fiskebolle30/Bachelor_Electronics_hardware/README.md

# Bachelor_Electronics_hardware
All PCB design files for the bachelor project. Project is made in KiCad
