fiskebolle30/Bachelor_Electronics_hardware/Bachelor_Main_PCB/Bachelor_Main_PCB_simple.step

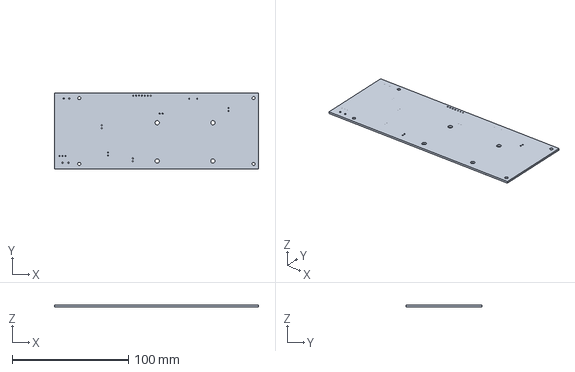
[picture p1: CAD file, 2025-04-30]
Bachelor_Main_PCB/Bachelor_Main_PCB_simple.step
175.8 x 65.1 x 1.52 mm
