fiskebolle30/Bachelor_Electronics_hardware/Bachelor_Main_PCB/KiCAD-Library_Bachelor_PCB/0402ESDA-MLP1/0402ESDA-MLP1.step

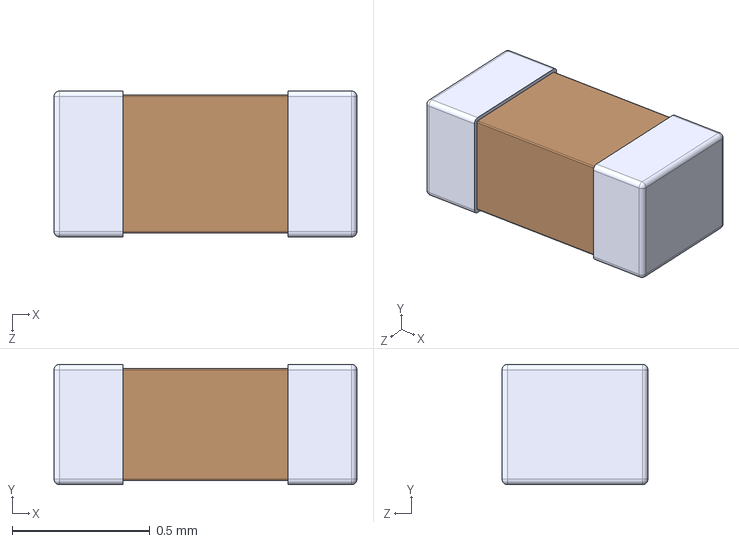
[picture p2: CAD file, 2025-04-09]
Bachelor_Main_PCB/KiCAD-Library_Bachelor_PCB/0402ESDA-MLP1/0402ESDA-MLP1.step
1.10 x 0.436 x 0.53 mm
