fiskebolle30/Bachelor_Electronics_hardware/Bachelor_Main_PCB/KiCAD-Library_Bachelor_PCB/BK-916-TR/BK-916-TR.step

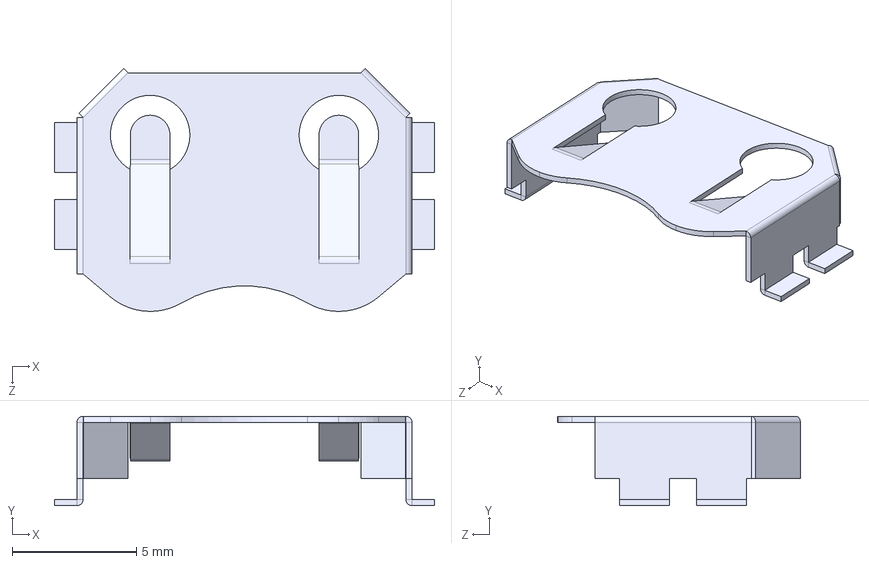
[picture p3: CAD file, 2025-04-02]
Bachelor_Main_PCB/KiCAD-Library_Bachelor_PCB/BK-916-TR/BK-916-TR.step
15.3 x 3.60 x 9.78 mm
