fiskebolle30/Bachelor_Electronics_hardware/Bachelor_Main_PCB/KiCAD-Library_Bachelor_PCB/CONMHF1-SMD-G-T/CONMHF1-SMD-G-T.step

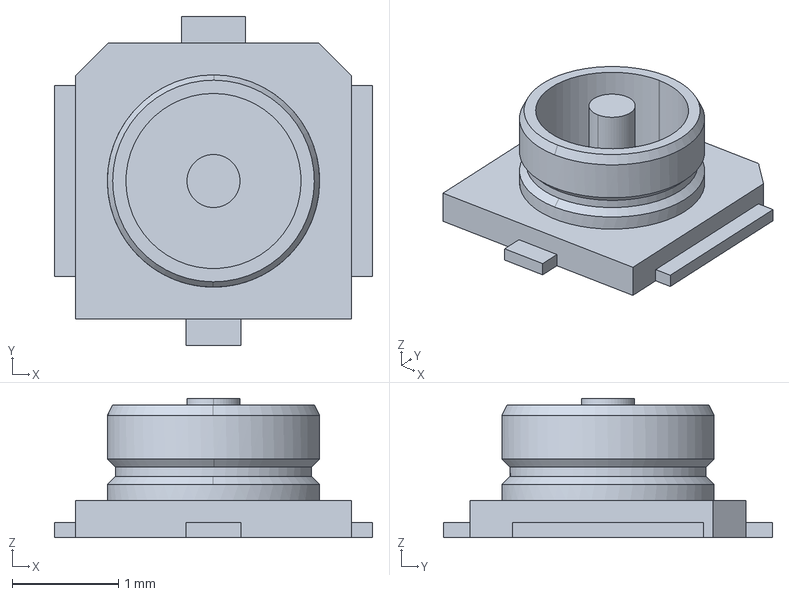
[picture p4: CAD file, 2025-04-09]
Bachelor_Main_PCB/KiCAD-Library_Bachelor_PCB/CONMHF1-SMD-G-T/CONMHF1-SMD-G-T.step
3.00 x 3.10 x 1.31 mm
