fiskebolle30/Bachelor_Electronics_hardware/Bachelor_Main_PCB/KiCAD-Library_Bachelor_PCB/ECS-327TXO-30-TR/ECS-327TXO-30-TR.step

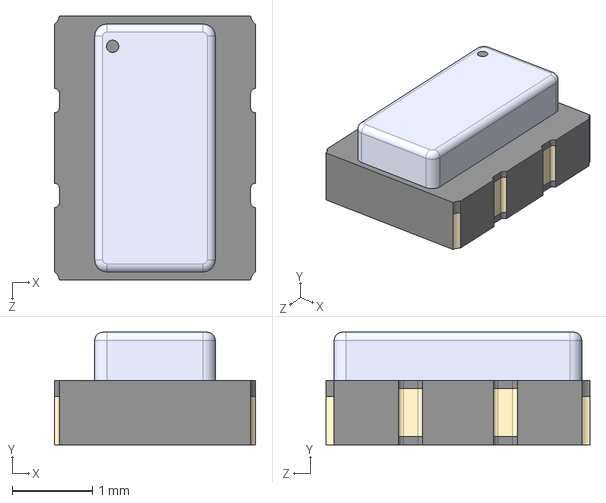
[picture p5: CAD file, 2025-04-04]
Bachelor_Main_PCB/KiCAD-Library_Bachelor_PCB/ECS-327TXO-30-TR/ECS-327TXO-30-TR.step
2.50 x 1.40 x 3.28 mm
