fiskebolle30/Bachelor_Electronics_hardware/Bachelor_Main_PCB/KiCAD-Library_Bachelor_PCB/F32Q-1A7H1-11022/F32Q-1A7H1-11022.step

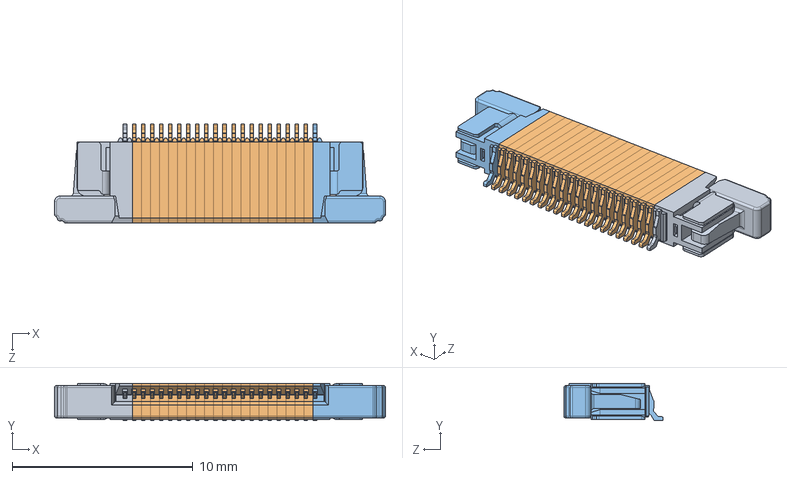
[picture p6: CAD file, 2025-03-14]
Bachelor_Main_PCB/KiCAD-Library_Bachelor_PCB/F32Q-1A7H1-11022/F32Q-1A7H1-11022.step
18.3 x 2.05 x 5.50 mm
F32Q_L.STEP
F32Q_M.STEP x 20
F32Q_R.STEP
