fiskebolle30/Bachelor_Electronics_hardware/Bachelor_Main_PCB/KiCAD-Library_Bachelor_PCB/LIB_BC817-40Q-13-F/BC817-40Q-13-F/3D/BC817-40Q-13-F.stp

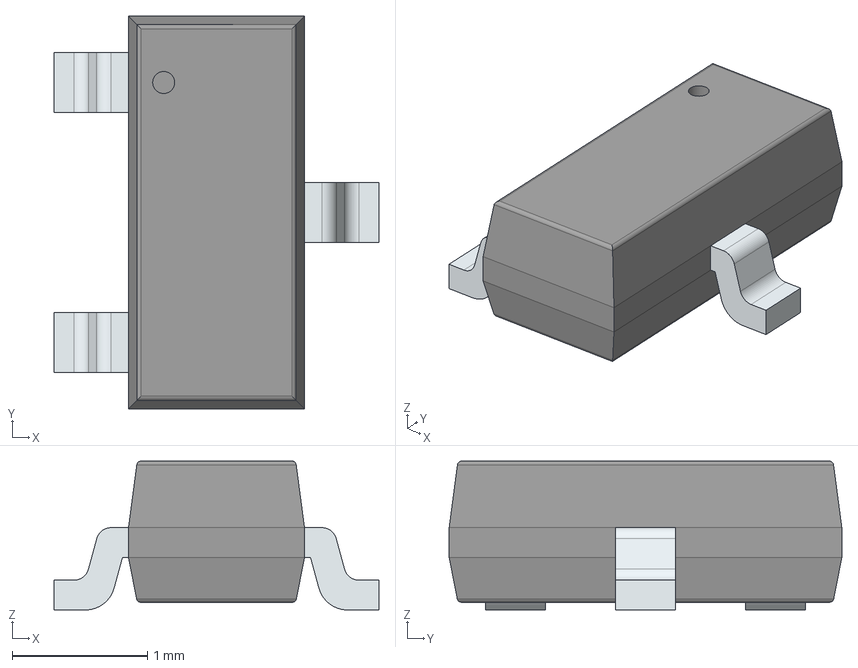
[picture p7: CAD file, 2025-04-15]
Bachelor_Main_PCB/KiCAD-Library_Bachelor_PCB/LIB_BC817-40Q-13-F/BC817-40Q-13-F/3D/BC817-40Q-13-F.stp
2.40 x 2.90 x 1.10 mm
PinsArrayL
FilletPinR
