fiskebolle30/Bachelor_Electronics_hardware/Bachelor_Main_PCB/KiCAD-Library_Bachelor_PCB/LIB_ESD7004MUTAG/ESD7004MUTAG/3D/ESD7004MUTAG.stp

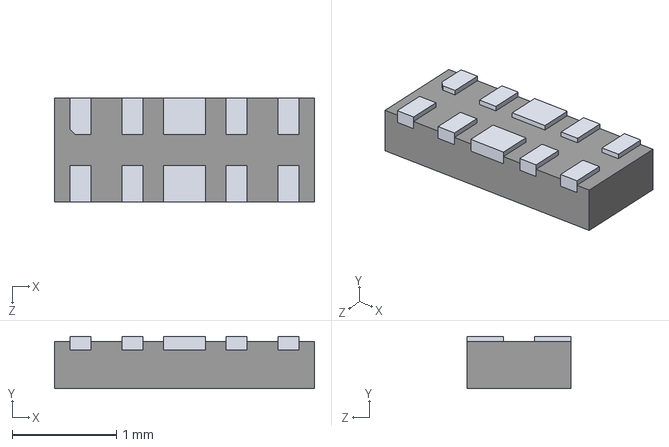
[picture p8: CAD file, 2025-04-07]
Bachelor_Main_PCB/KiCAD-Library_Bachelor_PCB/LIB_ESD7004MUTAG/ESD7004MUTAG/3D/ESD7004MUTAG.stp
2.50 x 0.5 x 1.00 mm
