fiskebolle30/Bachelor_Electronics_hardware/Bachelor_Main_PCB/KiCAD-Library_Bachelor_PCB/LIB_LD3985M18R/LD3985M18R/3D/LD3985M18R.stp

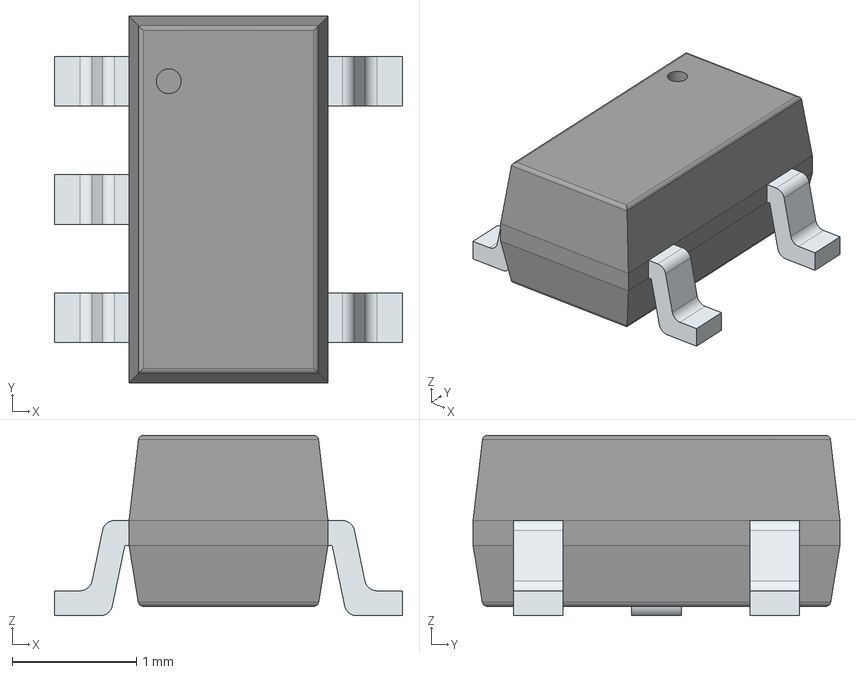
[picture p9: CAD file, 2025-04-12]
Bachelor_Main_PCB/KiCAD-Library_Bachelor_PCB/LIB_LD3985M18R/LD3985M18R/3D/LD3985M18R.stp
2.80 x 2.95 x 1.45 mm
PinsArrayL
PinsArrayR
