fiskebolle30/Bachelor_Electronics_hardware/Bachelor_Main_PCB/KiCAD-Library_Bachelor_PCB/LIB_SSM3J358R,LF/SSM3J358R,LF/3D/SSM3J358R,LF.stp

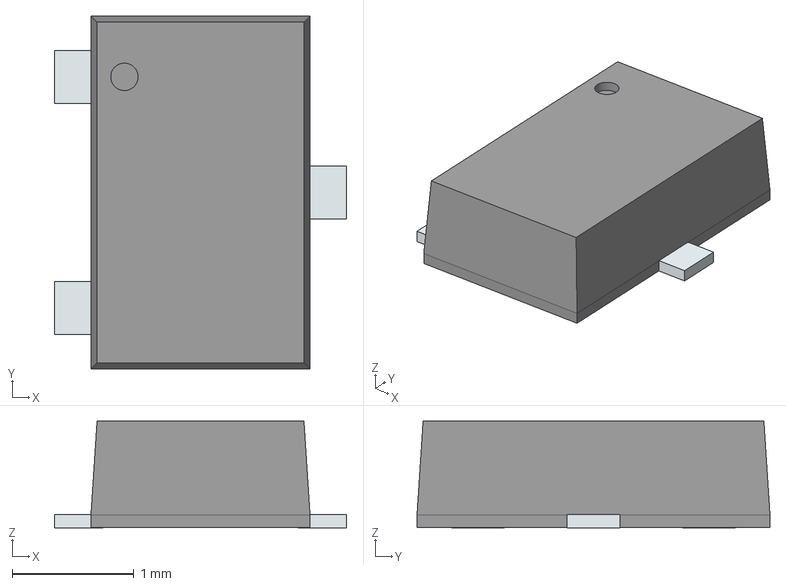
[picture p10: CAD file, 2025-04-08]
Bachelor_Main_PCB/KiCAD-Library_Bachelor_PCB/LIB_SSM3J358R,LF/SSM3J358R,LF/3D/SSM3J358R,LF.stp
2.40 x 2.90 x 0.878 mm
PinsArrayL
PinsArrayR
