fiskebolle30/Bachelor_Electronics_hardware/Bachelor_Main_PCB/KiCAD-Library_Bachelor_PCB/LQM2HPN1R0MJHL/LQM2HPN1R0MJHL.step

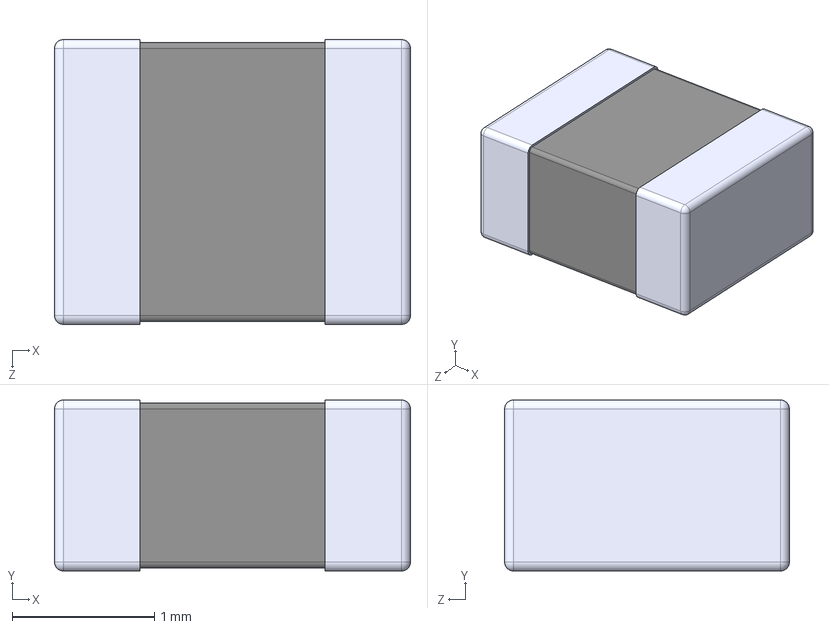
[picture p11: CAD file, 2025-04-01]
Bachelor_Main_PCB/KiCAD-Library_Bachelor_PCB/LQM2HPN1R0MJHL/LQM2HPN1R0MJHL.step
2.50 x 1.20 x 2.00 mm
