fiskebolle30/Bachelor_Electronics_hardware/Bachelor_Main_PCB/KiCAD-Library_Bachelor_PCB/LTST-C190GKT/LTST-C190GKT.step

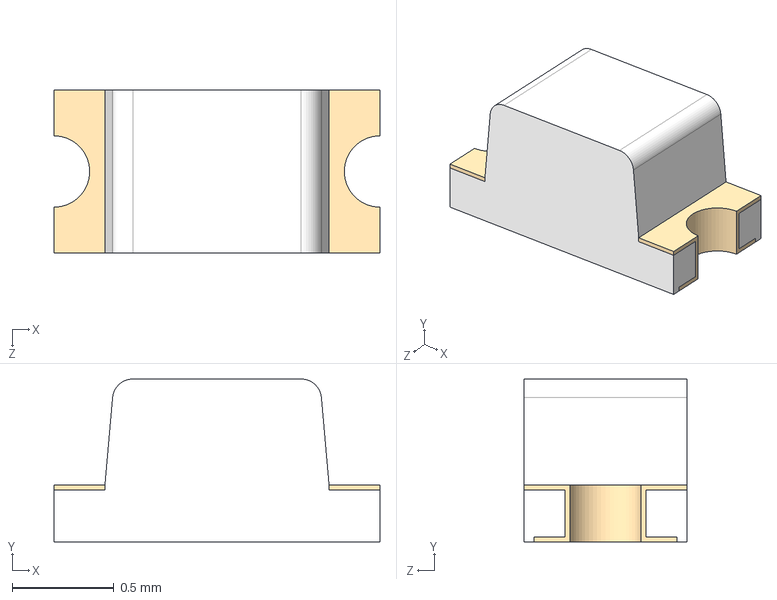
[picture p12: CAD file, 2025-04-15]
Bachelor_Main_PCB/KiCAD-Library_Bachelor_PCB/LTST-C190GKT/LTST-C190GKT.step
1.60 x 0.8 x 0.8 mm
