fiskebolle30/Bachelor_Electronics_hardware/Bachelor_Main_PCB/KiCAD-Library_Bachelor_PCB/MEM2075-00-140-01-A/MEM2075-00-140-01-A.step

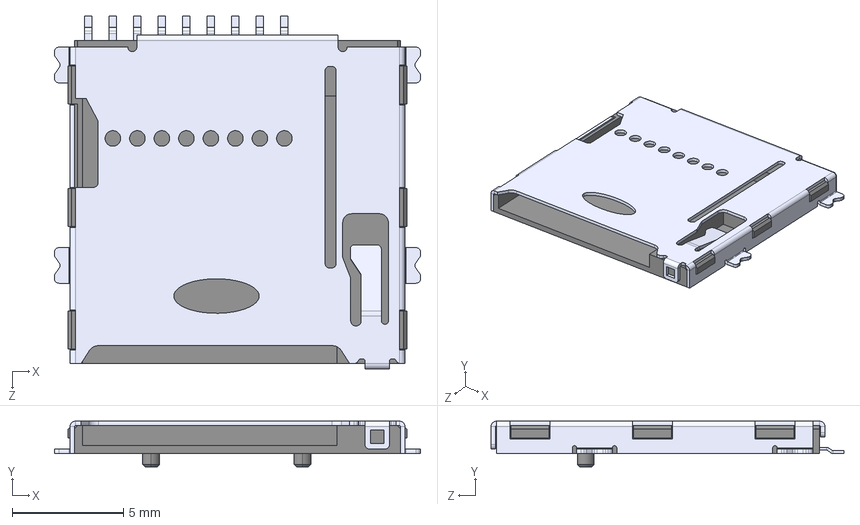
[picture p13: CAD file, 2025-04-09]
Bachelor_Main_PCB/KiCAD-Library_Bachelor_PCB/MEM2075-00-140-01-A/MEM2075-00-140-01-A.step
16.4 x 2.05 x 15.9 mm
