fiskebolle30/Bachelor_Electronics_hardware/Bachelor_Main_PCB/KiCAD-Library_Bachelor_PCB/SF70S006VBAR2000/SF70S006VBAR2000.step

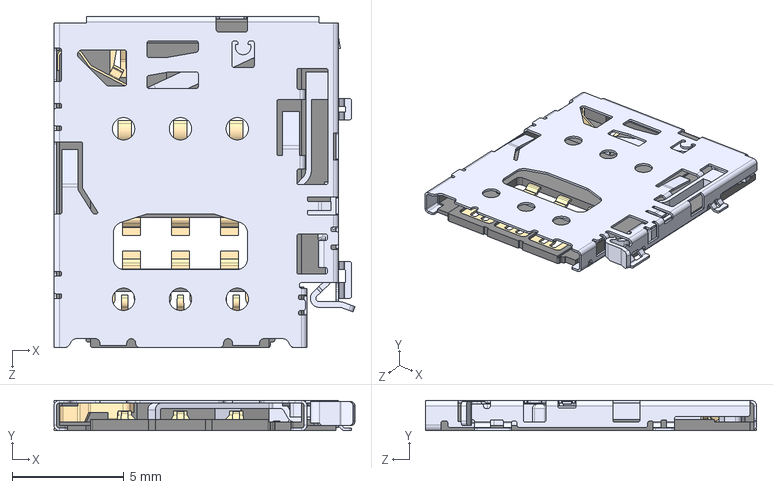
[picture p14: CAD file, 2025-04-22]
Bachelor_Main_PCB/KiCAD-Library_Bachelor_PCB/SF70S006VBAR2000/SF70S006VBAR2000.step
13.5 x 1.35 x 14.8 mm
