fiskebolle30/Bachelor_Electronics_hardware/Bachelor_Main_PCB/KiCAD-Library_Bachelor_PCB/SG-210STF_1.2000ML/SG-210STF_1.2000ML.step

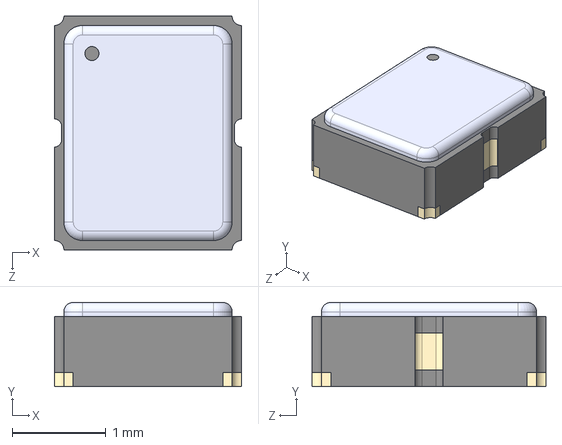
[picture p15: CAD file, 2025-03-26]
Bachelor_Main_PCB/KiCAD-Library_Bachelor_PCB/SG-210STF_1.2000ML/SG-210STF_1.2000ML.step
2.00 x 0.9 x 2.50 mm
