fiskebolle30/Bachelor_Electronics_hardware/Bachelor_Main_PCB/KiCAD-Library_Bachelor_PCB/USB3320C-EZK-TR/USB3320C-EZK-TR.step

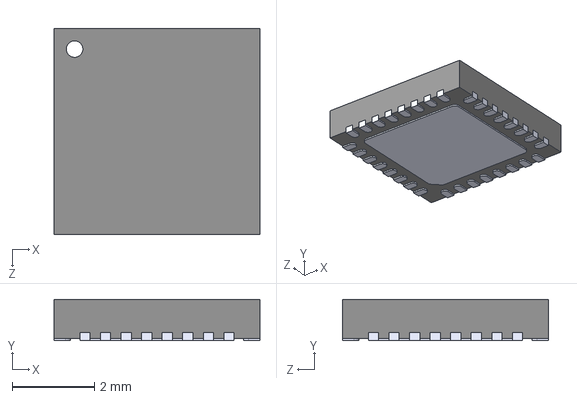
[picture p16: CAD file, 2025-03-24]
Bachelor_Main_PCB/KiCAD-Library_Bachelor_PCB/USB3320C-EZK-TR/USB3320C-EZK-TR.step
5.00 x 1.00 x 5.00 mm
