fiskebolle30/Bachelor_Electronics_hardware/Bachelor_Main_PCB/KiCAD-Library_Bachelor_PCB/WA-SMSI_9774XXX151/WA-SMSI_9774XXX151.step

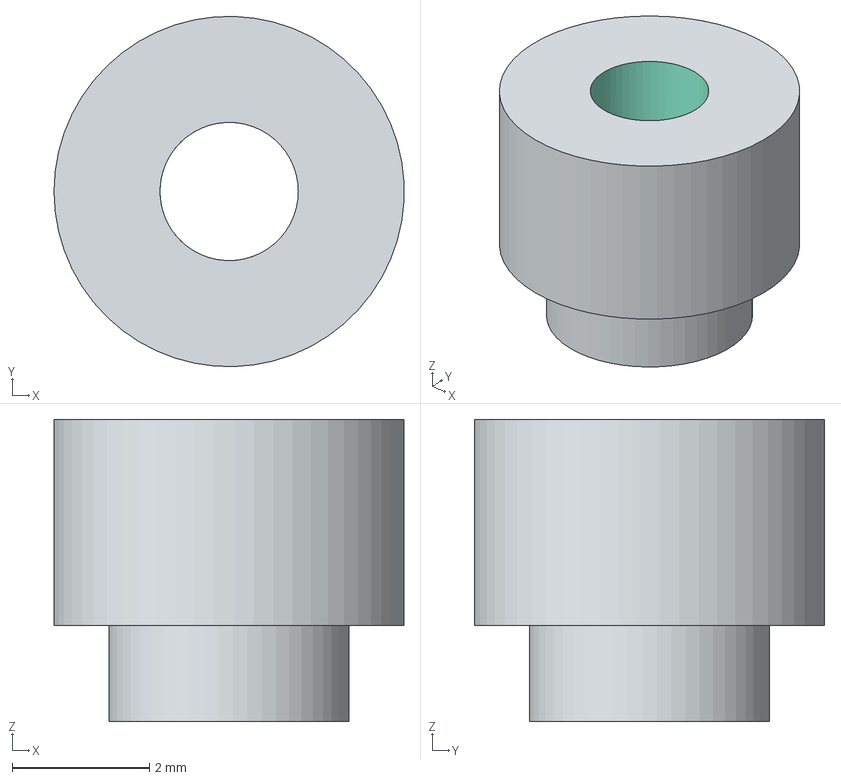
[picture p17: CAD file, 2025-03-17]
Bachelor_Main_PCB/KiCAD-Library_Bachelor_PCB/WA-SMSI_9774XXX151/WA-SMSI_9774XXX151.step
5.10 x 5.10 x 4.40 mm
