fiskebolle30/Bachelor_Electronics_hardware/Bachelor_Main_PCB/KiCAD-Library_Bachelor_PCB/WE-LHMI_7050_3uH3/WE-LHMI_7050_3uH3.step

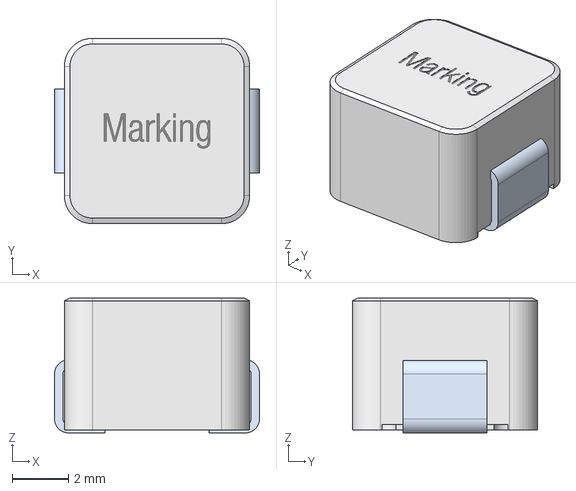
[picture p18: CAD file, 2025-04-14]
Bachelor_Main_PCB/KiCAD-Library_Bachelor_PCB/WE-LHMI_7050_3uH3/WE-LHMI_7050_3uH3.step
7.30 x 6.60 x 4.80 mm
