fiskebolle30/Bachelor_Electronics_hardware/(list of files, cad)

Other CAD files:
Bachelor_Main_PCB/KiCAD-Library_Bachelor_PCB/691137710002/691137710002.step
Bachelor_Main_PCB/KiCAD-Library_Bachelor_PCB/LIB_BC817-40Q-13-F/BC817-40Q-13-F/Allegro/sot96p240x110-3n.psm
Bachelor_Main_PCB/KiCAD-Library_Bachelor_PCB/LIB_BC817-40Q-13-F/BC817-40Q-13-F/DEHDL/bc817_40q_13_f/chips/chips.prt
Bachelor_Main_PCB/KiCAD-Library_Bachelor_PCB/LIB_ESD7004MUTAG/ESD7004MUTAG/DEHDL/esd7004mutag/chips/chips.prt
Bachelor_Main_PCB/KiCAD-Library_Bachelor_PCB/LIB_LD3985M18R/LD3985M18R/Allegro/sot95p280x145-5n.psm
Bachelor_Main_PCB/KiCAD-Library_Bachelor_PCB/LIB_LD3985M18R/LD3985M18R/DEHDL/ld3985m18r/chips/chips.prt
Bachelor_Main_PCB/KiCAD-Library_Bachelor_PCB/LIB_SSM3J358R,LF/SSM3J358R,LF/Allegro/sotfl95p240x88-3n.psm
Bachelor_Main_PCB/KiCAD-Library_Bachelor_PCB/LIB_SSM3J358R,LF/SSM3J358R,LF/DEHDL/ssm3j358r_lf/chips/chips.prt
Bachelor_Main_PCB/KiCAD-Library_Bachelor_PCB/LM73100RPWR/LM73100RPWR.step
Bachelor_Main_PCB/KiCAD-Library_Bachelor_PCB/LMR51450FNDRRR/LMR51450FNDRRR.step
Bachelor_Main_PCB/KiCAD-Library_Bachelor_PCB/M20-9990245/M20-9990245.step
Bachelor_Main_PCB/KiCAD-Library_Bachelor_PCB/RC7620_1104625/5302491_asm/5302491_asm.stp
Fusion assembly/Bachelor_Main_pcb_Housing v15.f3d
