fiskebolle30/Bachelor_Electronics_hardware/Bachelor_Main_PCB/Bachelor_Main_PCB.kicad_pcb

## KiCad design Bachelor_Main_PCB/Bachelor_Main_PCB.kicad_pcb (2025-04-27)

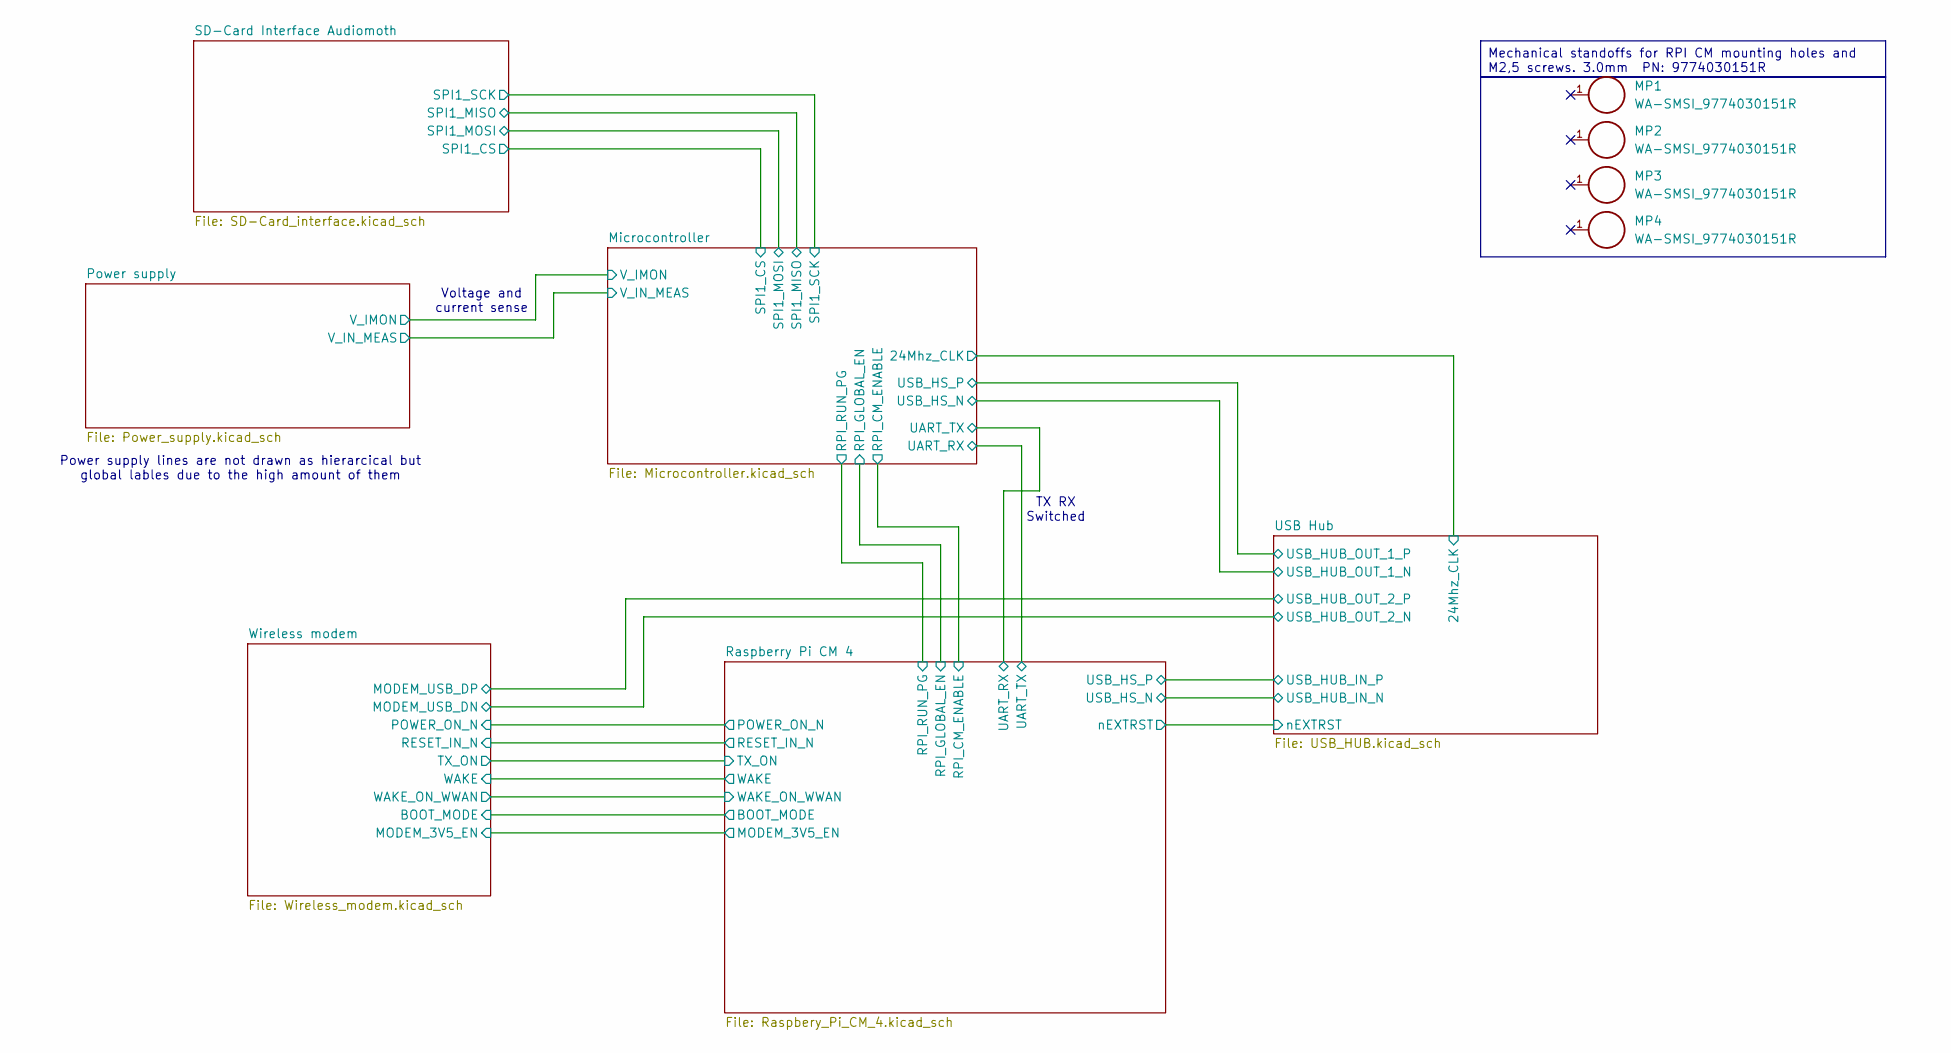
[picture p19: schematic Bachelor_Main_PCB.kicad_sch]

Parts:
MP1, MP2, MP3, MP4: WA-SMSI_9774030151R; WA-SMSI_9774030151; PART-NUMBER 9774030151R

Notes on the sheet:
TX RX Switched
Voltage and current sense
Power supply lines are not drawn as hierarcical but global lables due to the high amount of them
Mechanical standoffs for RPI CM mounting holes and M2,5 screws. 3.0mm PN: 9774030151R

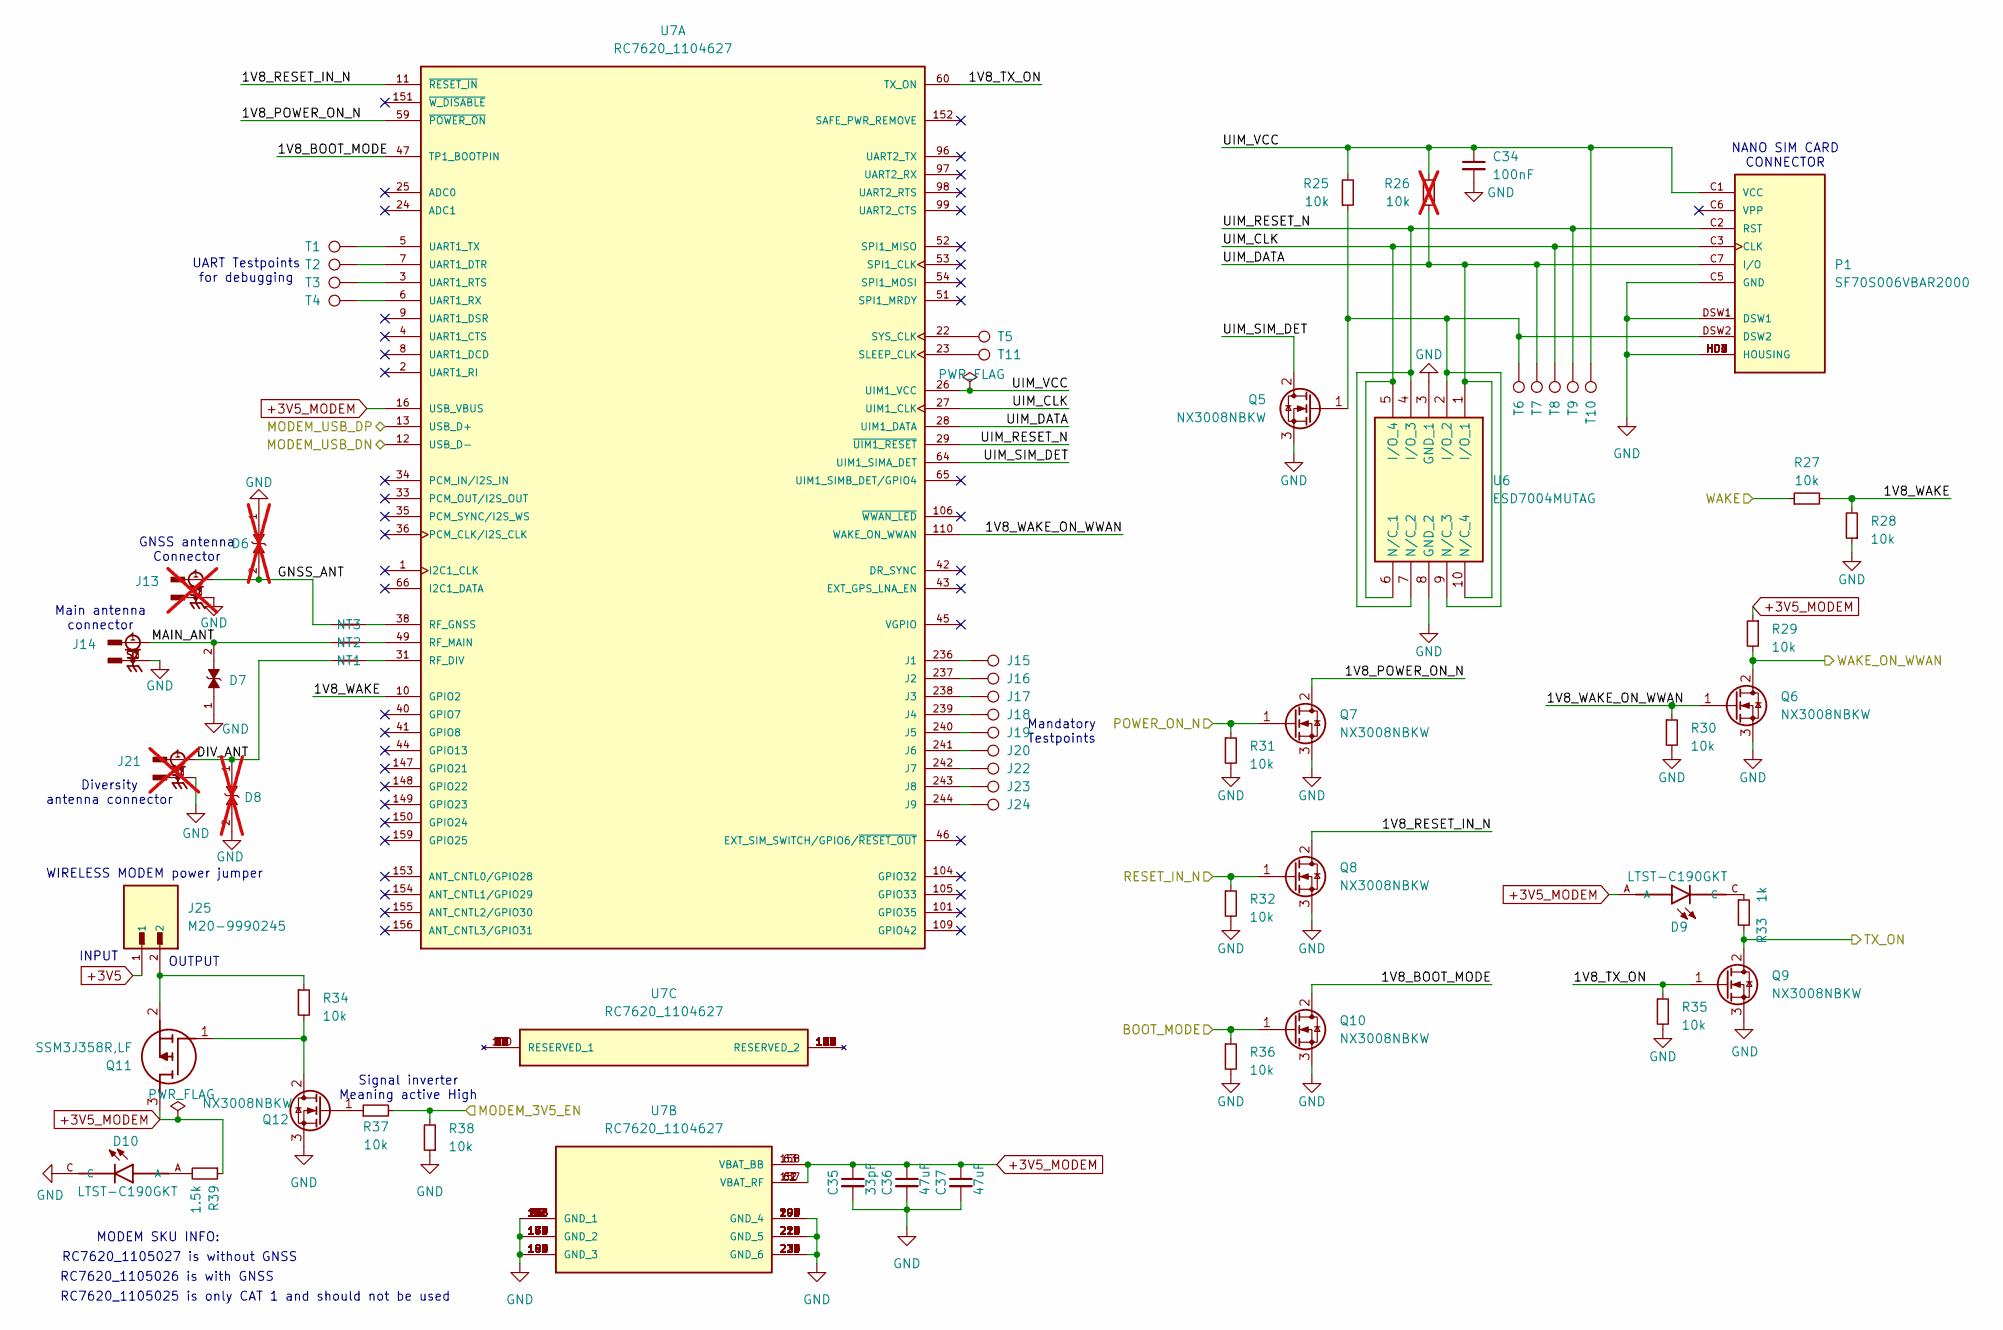
[picture p20: schematic Wireless_modem.kicad_sch]

Parts:
C34: 100nF; C_0603_1608Metric; Voltage 50V; Voltage rating 50v; MPN GRM155R71H104KE14D; Mouser 81-GRM155R71H104KE4D
C35: 33pF; C_0603_1608Metric; Voltage rating 50v; Part-no CL10C330JB8NNNC
C36, C37: 47uF; C_1206_3216Metric; Voltage rating 10v; Part-no GRM31CR61A476ME15L
D6, D8: 0402ESDA-MLP1; ESD_0402ESDA-MLP1; Part-no 0402ESDA-MLP1; not fitted
D7: 0402ESDA-MLP1; ESD_0402ESDA-MLP1; Part-no 0402ESDA-MLP1
D9, D10: LTST-C190GKT; LEDM1608X80; Part-no LTST-C190GKT
J13, J21: CONMHF1-SMD-G-T; LINX_CONMHF1-SMD-G-T; Part-no CONMHF1-SMD-G-T; not fitted
J14: CONMHF1-SMD-G-T; LINX_CONMHF1-SMD-G-T; Part-no CONMHF1-SMD-G-T
J15, J16, J17, J18, J19, J20, J22, J23, J24: TestPoint_Pad_D1.0mm
J25: M20-9990245; HARWIN_M20-9990245; PARTREV 14
NT1, NT2, NT3: NetTie_2; 0.3mm_to_0.41_net_tie
P1: SF70S006VBAR2000; JAE_SF70S006VBAR2000
Q5, Q6, Q7, Q8, Q9, Q10, Q12: NX3008NBKW; SOT-323_SC-70; MPN NX3008NBKW; Digikey 1727-1280-6-ND
Q11: SSM3J358R,LF; SOTFL95P240X88-3N; Manufacturer_Part_Number SSM3J358R,LF; Mouser Part Number 757-SSM3J358RLF
R25, R27, R28, R29, R30, R31, R32, R34, R35, R36, R37, R38: 10k; R_0603_1608Metric; Part-no RC0603FR-0710KL
R26: 10k; R_0603_1608Metric; not fitted
R33: 1k; R_0603_1608Metric
R39: 1.5k; R_0603_1608Metric
T1, T2, T3, T4, T5, T6, T7, T8, T9, T10, T11: TestPoint_Pad_D1.0mm
U6: ESD7004MUTAG; UDFN10_CASE_517BB; Manufacturer_Part_Number ESD7004MUTAG; Mouser Part Number 863-ESD7004MUTAG
U7: RC7620_1104627; XCVR_RC7620_1104625; PARTREV 12

Connections:
+3V5: J25.1; also elsewhere on the board
+3V5_MODEM: C35.1, C36.1, C37.1, D9.A, Q11.3 (D), R29.1, R39.1, U7.16 (USB_VBUS), U7.61 (VBAT_RF), U7.62 (VBAT_RF), U7.63 (VBAT_BB), U7.157 (VBAT_RF), U7.158 (VBAT_BB)
/Raspberry Pi CM 4/BOOT_MODE: Q10.1 (G), R36.1; also elsewhere on the board
/Raspberry Pi CM 4/MODEM_3V5_EN: R37.2, R38.2; also elsewhere on the board
/Raspberry Pi CM 4/POWER_ON_N: Q7.1 (G), R31.1; also elsewhere on the board
/Raspberry Pi CM 4/RESET_IN_N: Q8.1 (G), R32.1; also elsewhere on the board
/Raspberry Pi CM 4/TX_ON: Q9.2 (D), R33.2; also elsewhere on the board
/Raspberry Pi CM 4/WAKE: R27.1; also elsewhere on the board
/Raspberry Pi CM 4/WAKE_ON_WWAN: Q6.2 (D), R29.2; also elsewhere on the board
/USB Hub/USB_HUB_OUT_2_N: U7.12 (USB_D-); also elsewhere on the board
/USB Hub/USB_HUB_OUT_2_P: U7.13 (USB_D+); also elsewhere on the board
/Wireless modem/1V8_BOOT_MODE: Q10.2 (D), U7.47 (TP1_BOOTPIN)
/Wireless modem/1V8_POWER_ON_N: Q7.2 (D), U7.59 (~POWER_ON)
/Wireless modem/1V8_RESET_IN_N: Q8.2 (D), U7.11 (~RESET_IN)
/Wireless modem/1V8_TX_ON: Q9.1 (G), R35.1, U7.60 (TX_ON)
/Wireless modem/1V8_WAKE: R27.2, R28.2, U7.10 (GPIO2)
/Wireless modem/1V8_WAKE_ON_WWAN: Q6.1 (G), R30.1, U7.110 (WAKE_ON_WWAN)
/Wireless modem/DIV_ANT: D8.1, J21.1, NT1.1
/Wireless modem/GNSS_ANT: D6.2, J13.1, NT3.1
/Wireless modem/MAIN_ANT: D7.2, J14.1, NT2.1
/Wireless modem/UIM_CLK: P1.C3 (CLK), T8.1, U6.5 (I/O_4), U6.6 (N/C_1), U7.27 (UIM1_CLK)
/Wireless modem/UIM_DATA: P1.C7 (I/O), R26.1, T7.1, U6.1 (I/O_1), U6.10 (N/C_4), U7.28 (UIM1_DATA)
/Wireless modem/UIM_RESET_N: P1.C2 (RST), T9.1, U6.4 (I/O_3), U6.7 (N/C_2), U7.29 (~UIM1_RESET)
/Wireless modem/UIM_SIM_DET: Q5.2 (D), U7.64 (UIM1_SIMA_DET)
/Wireless modem/UIM_VCC: C34.1, P1.C1 (VCC), R25.2, R26.2, T10.1, U7.26 (UIM1_VCC)
GND: C34.2, C35.2, C36.2, C37.2, D6.1, D7.1, D8.2, D10.C, J13.S1, J13.S2, J13.S3, J14.S1, J14.S2, J14.S3, J21.S1, J21.S2, J21.S3, P1.C5 (GND), P1.DSW1, P1.HD1 (HOUSING), P1.HD2 (HOUSING), P1.HD3 (HOUSING), P1.HD4 (HOUSING), P1.HD5 (HOUSING), P1.HD6 (HOUSING), P1.HD7 (HOUSING), Q5.3 (S), Q6.3 (S), Q7.3 (S), Q8.3 (S), Q9.3 (S), Q10.3 (S), Q12.3 (S), R28.1, R30.2, R31.2, R32.2, R35.2, R36.2, R38.1, U6.3 (GND_1), U6.8 (GND_2), U7.30 (GND_1), U7.32 (GND_1), U7.37 (GND_1), U7.39 (GND_1), U7.48 (GND_1), U7.50 (GND_1), U7.67 (GND_1), U7.68 (GND_1), U7.69 (GND_1), U7.70 (GND_1), U7.111 (GND_1), U7.113 (GND_1), U7.125 (GND_1), U7.128 (GND_1), U7.136 (GND_1), U7.139 (GND_2), U7.167 (GND_2), U7.168 (GND_2), U7.169 (GND_2), U7.170 (GND_2), U7.171 (GND_2), U7.172 (GND_2), U7.173 (GND_2), U7.174 (GND_2), U7.175 (GND_2), U7.176 (GND_2), U7.177 (GND_2), U7.178 (GND_2), U7.179 (GND_2), U7.180 (GND_2), U7.181 (GND_3), U7.182 (GND_3), U7.183 (GND_3), U7.184 (GND_3), U7.185 (GND_3), U7.186 (GND_3), U7.187 (GND_3), U7.188 (GND_3), U7.189 (GND_3), U7.190 (GND_3), U7.191 (GND_3), U7.192 (GND_3), U7.193 (GND_3), U7.194 (GND_3), U7.195 (GND_4), U7.196 (GND_4), U7.197 (GND_4), U7.198 (GND_4), U7.199 (GND_4), U7.200 (GND_4), U7.201 (GND_4), U7.202 (GND_4), U7.203 (GND_4), U7.204 (GND_4), U7.205 (GND_4), U7.206 (GND_4), U7.207 (GND_4), U7.208 (GND_4), U7.209 (GND_4), U7.210 (GND_5), U7.211 (GND_5), U7.212 (GND_5), U7.213 (GND_5), U7.214 (GND_5), U7.215 (GND_5), U7.216 (GND_5), U7.217 (GND_5), U7.218 (GND_5), U7.219 (GND_5), U7.220 (GND_5), U7.221 (GND_5), U7.222 (GND_5), U7.223 (GND_5), U7.224 (GND_5), U7.225 (GND_6), U7.226 (GND_6), U7.227 (GND_6), U7.228 (GND_6), U7.229 (GND_6), U7.230 (GND_6), U7.231 (GND_6), U7.232 (GND_6), U7.233 (GND_6), U7.234 (GND_6); also elsewhere on the board
unnamed: D9.C, R33.1
unnamed: D10.A, R39.2
unnamed: P1.DSW2, Q5.1 (G), R25.1, T6.1, U6.2 (I/O_2), U6.9 (N/C_3)
unnamed: Q11.1 (G), Q12.2 (D), R34.2
unnamed: J25.2, Q11.2 (S), R34.1
unnamed: Q12.1 (G), R37.1
unnamed: J15.1, U7.236 (J1)
unnamed: J16.1, U7.237 (J2)
unnamed: J17.1, U7.238 (J3)
unnamed: J18.1, U7.239 (J4)
unnamed: J19.1, U7.240 (J5)
unnamed: J20.1, U7.241 (J6)
unnamed: J22.1, U7.242 (J7)
unnamed: J23.1, U7.243 (J8)
unnamed: J24.1, U7.244 (J9)
unnamed: NT1.2, U7.31 (RF_DIV)
unnamed: NT3.2, U7.38 (RF_GNSS)
unnamed: NT2.2, U7.49 (RF_MAIN)
unnamed: T11.1, U7.23 (SLEEP_CLK)
unnamed: T5.1, U7.22 (SYS_CLK)
unnamed: T2.1, U7.7 (UART1_DTR)
unnamed: T3.1, U7.3 (UART1_RTS)
unnamed: T4.1, U7.6 (UART1_RX)
unnamed: T1.1, U7.5 (UART1_TX)

Notes on the sheet:
Main antenna connector
Diversity antenna connector
NANO SIM CARD CONNECTOR
INPUT
Mandatory Testpoints
OUTPUT
UART Testpoints for debugging
GNSS antenna Connector
RC7620_1105026 is with GNSS
RC7620_1105025 is only CAT 1 and should not be used
MODEM SKU INFO:
Signal inverter Meaning active High
RC7620_1105027 is without GNSS
WIRELESS MODEM power jumper

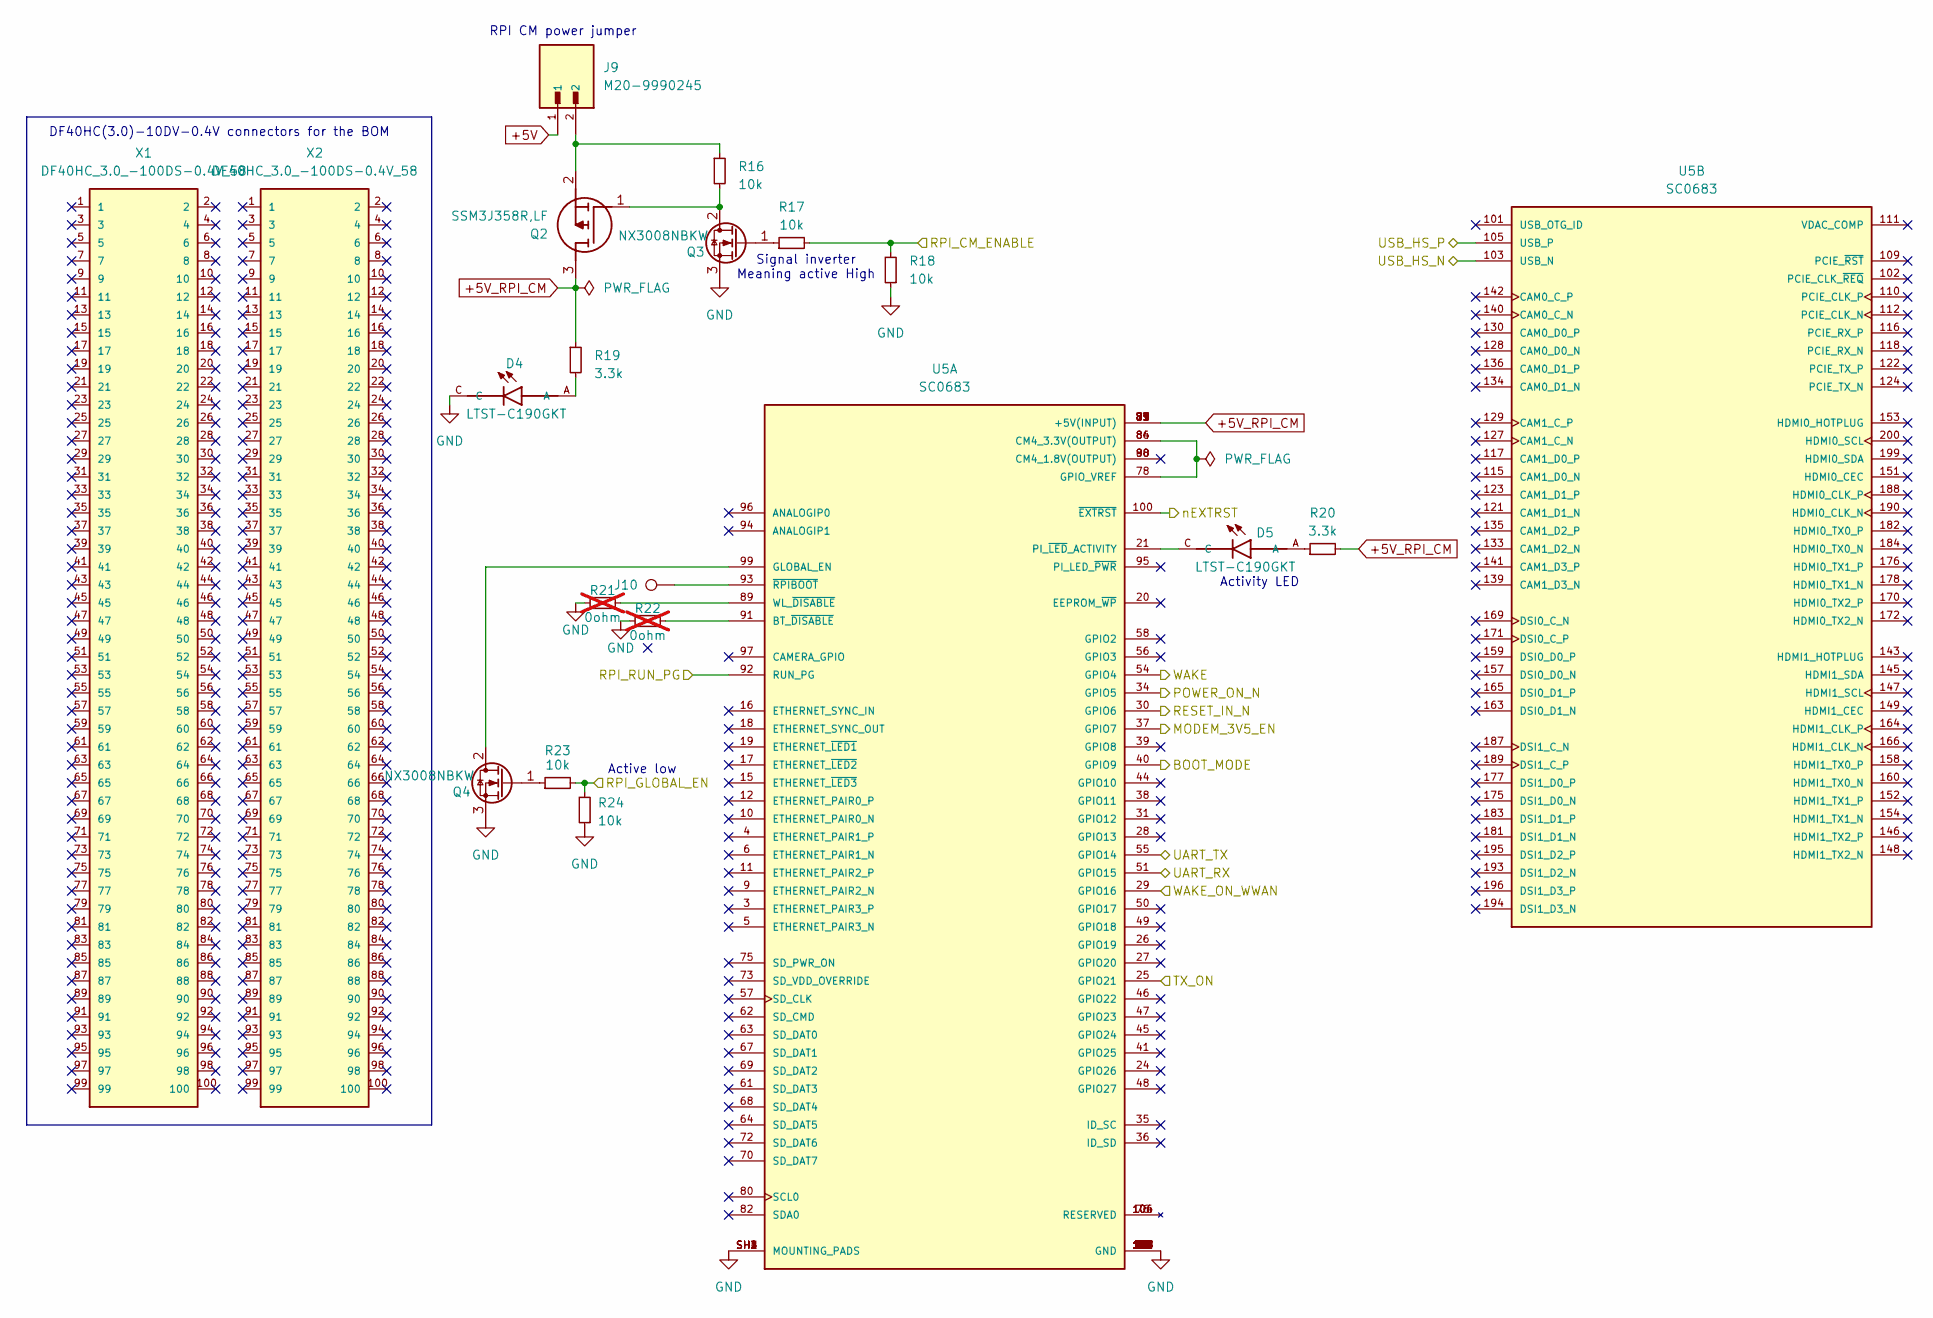
[picture p21: schematic Raspbery_Pi_CM_4.kicad_sch]

Parts:
D4, D5: LTST-C190GKT; LEDM1608X80; Part-no LTST-C190GKT
J9: M20-9990245; HARWIN_M20-9990245; PARTREV 14
J10: TestPoint_Pad_D1.0mm
Q2: SSM3J358R,LF; SOTFL95P240X88-3N; Manufacturer_Part_Number SSM3J358R,LF; Mouser Part Number 757-SSM3J358RLF
Q3, Q4: NX3008NBKW; SOT-323_SC-70; MPN NX3008NBKW; Digikey 1727-1280-6-ND
R16, R17, R18, R23, R24: 10k; R_0603_1608Metric; Part-no RC0603FR-0710KL
R19, R20: 3.3k; R_0603_1608Metric
R21, R22: 0ohm; R_0603_1608Metric; not fitted
U5: SC0683; MODULE_SC0683; PARTREV 2021-10-12
X1, X2: DF40HC_3.0_-100DS-0.4V_58; HRS_DF40HC_3.0_-100DS-0.4V_58; Part-no DF40HC_3.0_-100DS-0.4V_58

Connections:
+5V: J9.1; also elsewhere on the board
+5V_RPI_CM: Q2.3 (D), R19.1, R20.2, U5.77 (+5V(INPUT)), U5.79 (+5V(INPUT)), U5.81 (+5V(INPUT)), U5.83 (+5V(INPUT)), U5.85 (+5V(INPUT)), U5.87 (+5V(INPUT))
/Microcontroller/RPI_CM_ENABLE: R17.2, R18.2; also elsewhere on the board
/Microcontroller/RPI_GLOBAL_EN: R23.2, R24.2; also elsewhere on the board
/Microcontroller/RPI_RUN_PG: U5.92 (RUN_PG); also elsewhere on the board
/Microcontroller/UART_RX: U5.55 (GPIO14); also elsewhere on the board
/Microcontroller/UART_TX: U5.51 (GPIO15); also elsewhere on the board
/Raspberry Pi CM 4/BOOT_MODE: U5.40 (GPIO9); also elsewhere on the board
/Raspberry Pi CM 4/MODEM_3V5_EN: U5.37 (GPIO7); also elsewhere on the board
/Raspberry Pi CM 4/POWER_ON_N: U5.34 (GPIO5); also elsewhere on the board
/Raspberry Pi CM 4/RESET_IN_N: U5.30 (GPIO6); also elsewhere on the board
/Raspberry Pi CM 4/TX_ON: U5.25 (GPIO21); also elsewhere on the board
/Raspberry Pi CM 4/USB_HS_N: U5.103 (USB_N); also elsewhere on the board
/Raspberry Pi CM 4/USB_HS_P: U5.105 (USB_P); also elsewhere on the board
/Raspberry Pi CM 4/WAKE: U5.54 (GPIO4); also elsewhere on the board
/Raspberry Pi CM 4/WAKE_ON_WWAN: U5.29 (GPIO16); also elsewhere on the board
/Raspberry Pi CM 4/nEXTRST: U5.100 (~EXTRST); also elsewhere on the board
GND: D4.C, Q3.3 (S), Q4.3 (S), R18.1, R21.1, R22.1, R24.1, U5.1 (GND), U5.2 (GND), U5.7 (GND), U5.8 (GND), U5.13 (GND), U5.14 (GND), U5.22 (GND), U5.23 (GND), U5.32 (GND), U5.33 (GND), U5.42 (GND), U5.43 (GND), U5.52 (GND), U5.53 (GND), U5.59 (GND), U5.60 (GND), U5.65 (GND), U5.66 (GND), U5.71 (GND), U5.74 (GND), U5.98 (GND), U5.107 (GND), U5.108 (GND), U5.113 (GND), U5.114 (GND), U5.119 (GND), U5.120 (GND), U5.125 (GND), U5.126 (GND), U5.131 (GND), U5.132 (GND), U5.137 (GND), U5.138 (GND), U5.144 (GND), U5.150 (GND), U5.155 (GND), U5.156 (GND), U5.161 (GND), U5.162 (GND), U5.167 (GND), U5.168 (GND), U5.173 (GND), U5.174 (GND), U5.179 (GND), U5.180 (GND), U5.185 (GND), U5.186 (GND), U5.191 (GND), U5.192 (GND), U5.197 (GND), U5.198 (GND), U5.SH1 (MOUNTING_PADS), U5.SH2 (MOUNTING_PADS), U5.SH3 (MOUNTING_PADS), U5.SH4 (MOUNTING_PADS); also elsewhere on the board
unnamed: D4.A, R19.2
unnamed: D5.A, R20.1
unnamed: Q2.1 (G), Q3.2 (D), R16.2
unnamed: J9.2, Q2.2 (S), R16.1
unnamed: Q3.1 (G), R17.1
unnamed: Q4.2 (D), U5.99 (GLOBAL_EN)
unnamed: Q4.1 (G), R23.1
unnamed: R22.2, U5.91 (BT_~DISABLE)
unnamed: U5.78 (GPIO_VREF), U5.84 (CM4_3.3V(OUTPUT)), U5.86 (CM4_3.3V(OUTPUT))
unnamed: D5.C, U5.21 (PI_~LED_ACTIVITY)
unnamed: R21.2, U5.89 (WL_~DISABLE)
unnamed: J10.1, U5.93 (~RPIBOOT)

Notes on the sheet:
Signal inverter Meaning active High
Active low
RPI CM power jumper
DF40HC(3.0)-10DV-0.4V connectors for the BOM
Activity LED

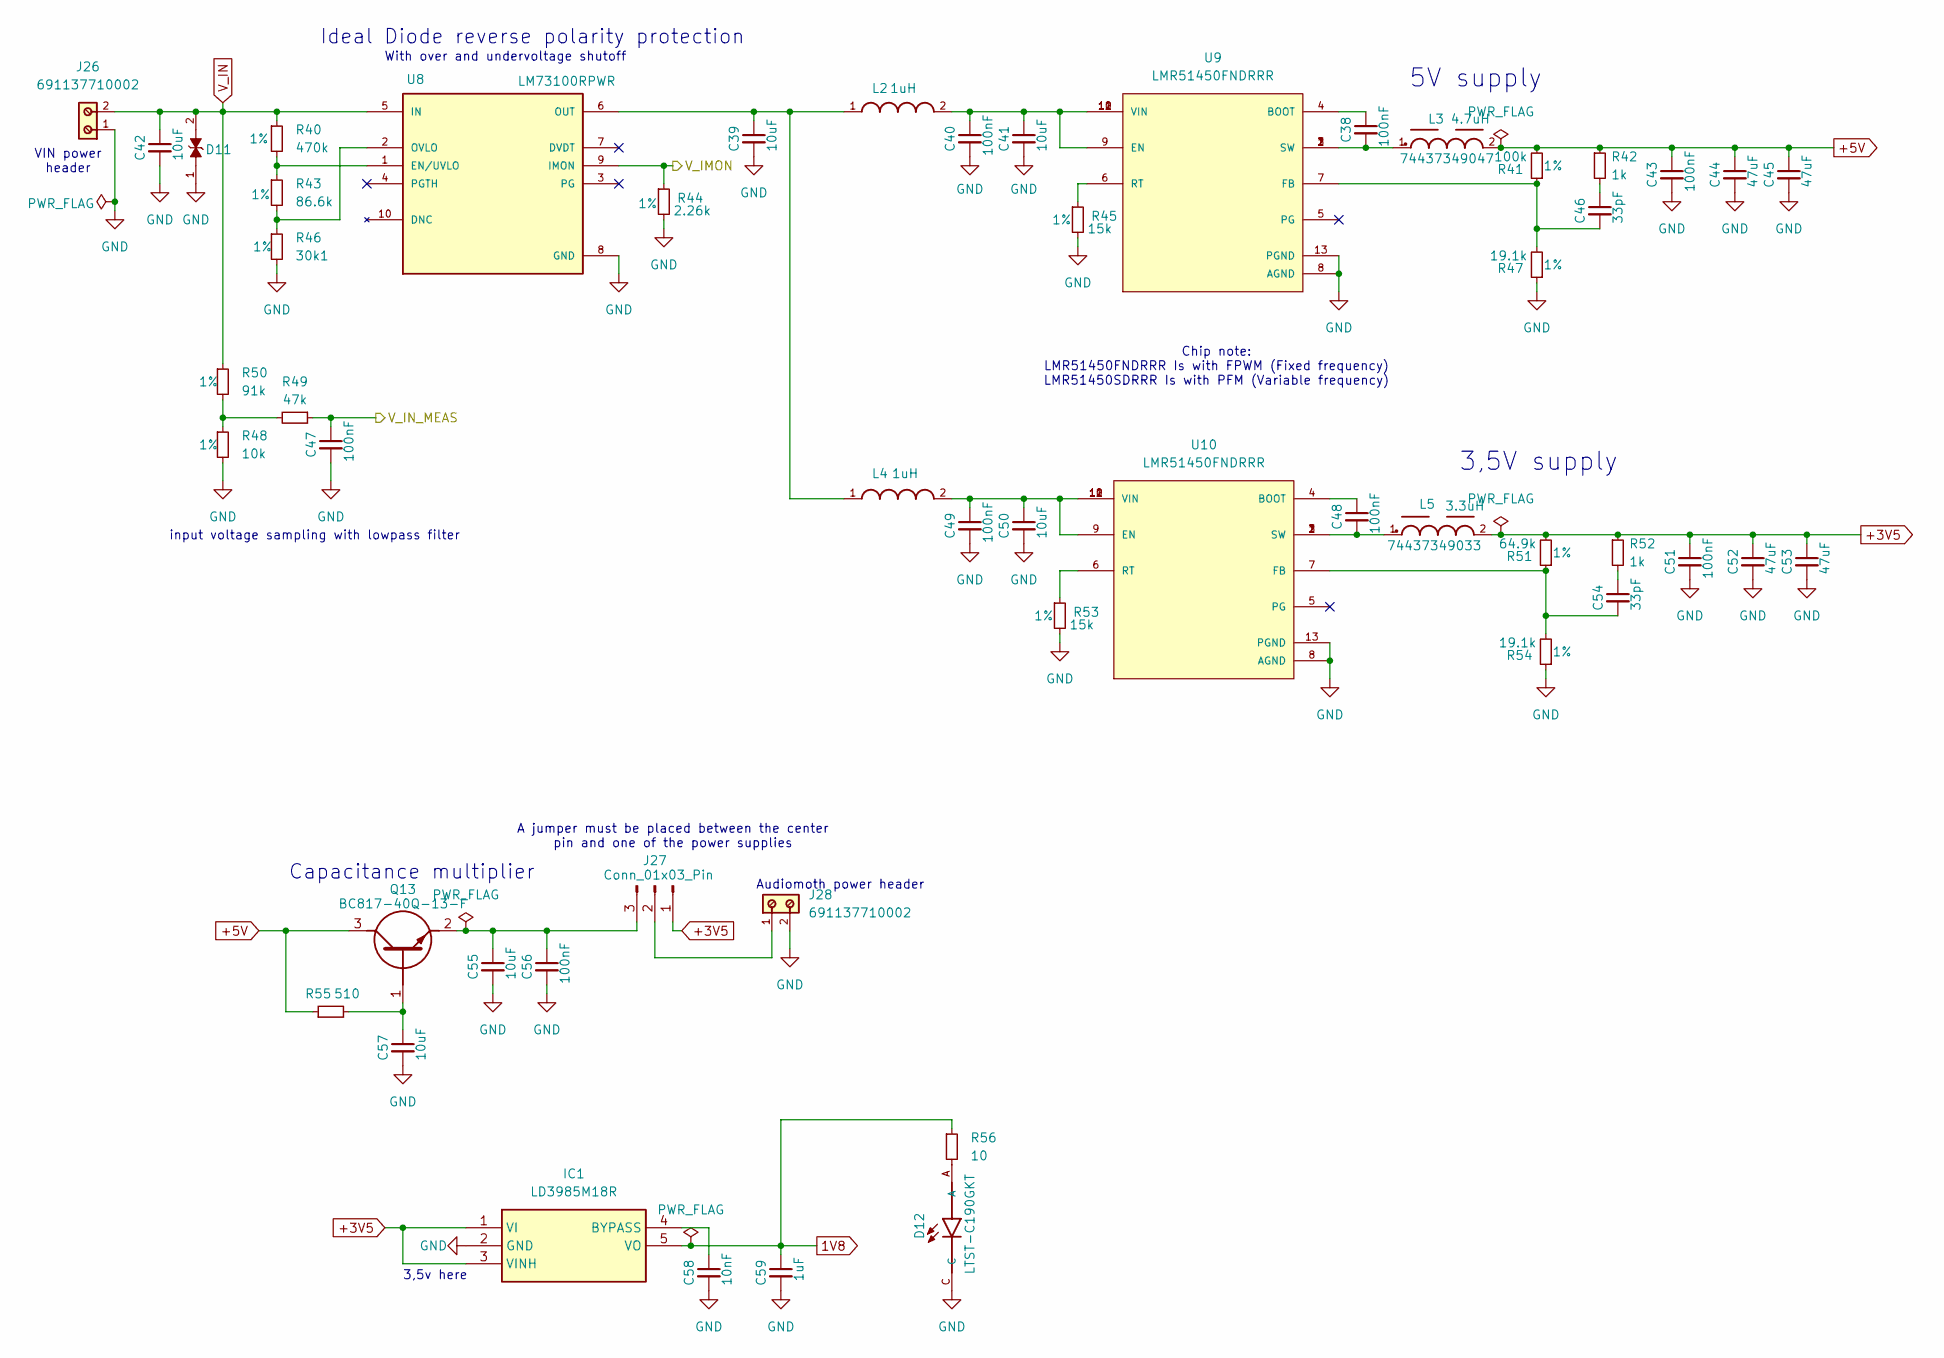
[picture p22: schematic Power_supply.kicad_sch]

Parts:
C38, C40, C43, C47, C48, C49, C51, C56: 100nF; C_0603_1608Metric; Voltage rating 50v; Part-no CL10B104KB8NNWC
C39, C41, C42, C50, C55, C57: 10uF; C_1206_3216Metric; Voltage rating 50v; Part-no CL31B106KBHNNNE
C44, C45, C52, C53: 47uF; C_1206_3216Metric; Voltage rating 10v; Part-no GRM31CR61A476ME15L
C46, C54: 33pF; C_0603_1608Metric; Voltage rating 50v; Part-no CL10C330JB8NNNC
C58: 10nF; C_0603_1608Metric; Voltage rating 50v; Part-no CL10B103KB8NNNC
C59: 1uF; C_0603_1608Metric; Voltage rating 16v; Part-no CL10B105KO8NNNC
D11: 0402ESDA-MLP1; ESD_0402ESDA-MLP1; Part-no 0402ESDA-MLP1
D12: LTST-C190GKT; LEDM1608X80; Part-no LTST-C190GKT
IC1: LD3985M18R; SOT95P280X145-5N; Manufacturer_Part_Number LD3985M18R; Mouser Part Number 511-LD3985M18R
J26, J28: 691137710002; Part-no 691137710002
J27: Conn_01x03_Pin; PinHeader_1x03_P2.54mm_Vertical
L2, L4: 1uH; INDC2520X120N; Part-no LQM2HPN1R0MJHL
L3: 4.7uH; WE-LHMI_7050; Part-no 74437349047
L5: 3.3uH; WE-LHMI_7050; Part-no 74437349033
Q13: BC817-40Q-13-F; SOT96P240X110-3N; Manufacturer_Part_Number BC817-40Q-13-F; Mouser Part Number 621-BC817-40Q-13-F
R40: 470k; R_0603_1608Metric; Tolerance 1%; Part-no RMCF0603FT470K
R41: 100k; R_0603_1608Metric; Tolerance 1%; Part-no RMCF0603FT100K
R42, R52: 1k; R_0603_1608Metric
R43: 86.6k; R_0603_1608Metric; Tolerance 1%; Part-no RC0603FR-0786K6L
R44: 2.26k; R_0603_1608Metric; Tolerance 1%; Part-no RC0603FR-072K26L
R45, R53: 15k; R_0603_1608Metric; Tolerance 1%; Part-no RC0603FR-0715KL
R46: 30k1; R_0603_1608Metric; Tolerance 1%; Part-no RMCF0603FT30K1
R47, R54: 19.1k; R_0603_1608Metric; Tolerance 1%; Part-no RC0603FR-0719K1L
R48: 10k; R_0603_1608Metric; Tolerance 1%; Part-no RC0603FR-0710KL
R49: 47k; R_0603_1608Metric
R50: 91k; R_0603_1608Metric; Tolerance 1%; Part-no RC0603FR-0791KL
R51: 64.9k; R_0603_1608Metric; Tolerance 1%; Part-no RC0603FR-0764K9L
R55: 510; R_0603_1608Metric
R56: 10; R_0603_1608Metric
U8: LM73100RPWR; IC_LM73100RPWR; PARTREV 08/2019
U9, U10: LMR51450FNDRRR; CONV_LMR51450FNDRRR; PARTREV December 2022

Connections:
1V8: C59.1, IC1.5 (VO), R56.1; also elsewhere on the board
+3V5: C51.1, C52.1, C53.1, IC1.1 (VI), IC1.3 (VINH), J27.1, L5.2, R51.2, R52.1; also elsewhere on the board
+5V: C43.1, C44.1, C45.1, L3.2, Q13.3 (C), R41.2, R42.1, R55.1; also elsewhere on the board
/Microcontroller/V_IMON: R44.1, U8.9 (IMON); also elsewhere on the board
/Microcontroller/V_IN_MEAS: C47.1, R49.1; also elsewhere on the board
GND: C39.2, C40.2, C41.2, C42.2, C43.2, C44.2, C45.2, C47.2, C49.2, C50.2, C51.2, C52.2, C53.2, C55.2, C56.2, C57.2, C58.2, C59.2, D11.1, D12.C, IC1.2 (GND), J26.1, J28.2, R44.2, R45.2, R46.2, R47.1, R48.2, R53.2, R54.1, U8.8 (GND), U9.8 (AGND), U9.13 (PGND), U10.8 (AGND), U10.13 (PGND); also elsewhere on the board
unnamed: C38.2, L3.1, U9.1 (SW), U9.2 (SW), U9.3 (SW)
unnamed: C46.1, R42.2
unnamed: C48.2, L5.1, U10.1 (SW), U10.2 (SW), U10.3 (SW)
unnamed: C54.1, R52.2
unnamed: D12.A, R56.2
unnamed: C58.1, IC1.4 (BYPASS)
unnamed: J27.2, J28.1
unnamed: C55.1, C56.1, J27.3, Q13.2 (E)
unnamed: C57.1, Q13.1 (B), R55.2
unnamed: R48.1, R49.2, R50.2
unnamed: R40.2, R43.1, U8.1 (EN/UVLO)
unnamed: C39.1, L2.1, L4.1, U8.6 (OUT)
unnamed: R43.2, R46.1, U8.2 (OVLO)
unnamed: C38.1, U9.4 (BOOT)
unnamed: C40.1, C41.1, L2.2, U9.9 (EN), U9.10 (VIN), U9.11 (VIN), U9.12 (VIN)
unnamed: C46.2, R41.1, R47.2, U9.7 (FB)
unnamed: R45.1, U9.6 (RT)
unnamed: C48.1, U10.4 (BOOT)
unnamed: C49.1, C50.1, L4.2, U10.9 (EN), U10.10 (VIN), U10.11 (VIN), U10.12 (VIN)
unnamed: C54.2, R51.1, R54.2, U10.7 (FB)
unnamed: R53.1, U10.6 (RT)
V_IN: C42.1, D11.2, J26.2, R40.1, R50.1, U8.5 (IN)

Notes on the sheet:
5V supply
Ideal Diode reverse polarity protection
Chip note: LMR51450FNDRRR Is with FPWM (Fixed frequency) LMR51450SDRRR Is with PFM (Variable frequency)
input voltage sampling with lowpass filter
3,5v here
Audiomoth power header
With over and undervoltage shutoff
Capacitance multiplier
3,5V supply
VIN power header
A jumper must be placed between the center pin and one of the power supplies
