fiskebolle30/Bachelor_Electronics_hardware/Bachelor_Main_PCB/Bachelor_Main_PCB.kicad_pcb

## KiCad design Bachelor_Main_PCB/Bachelor_Main_PCB.kicad_pcb (continued)

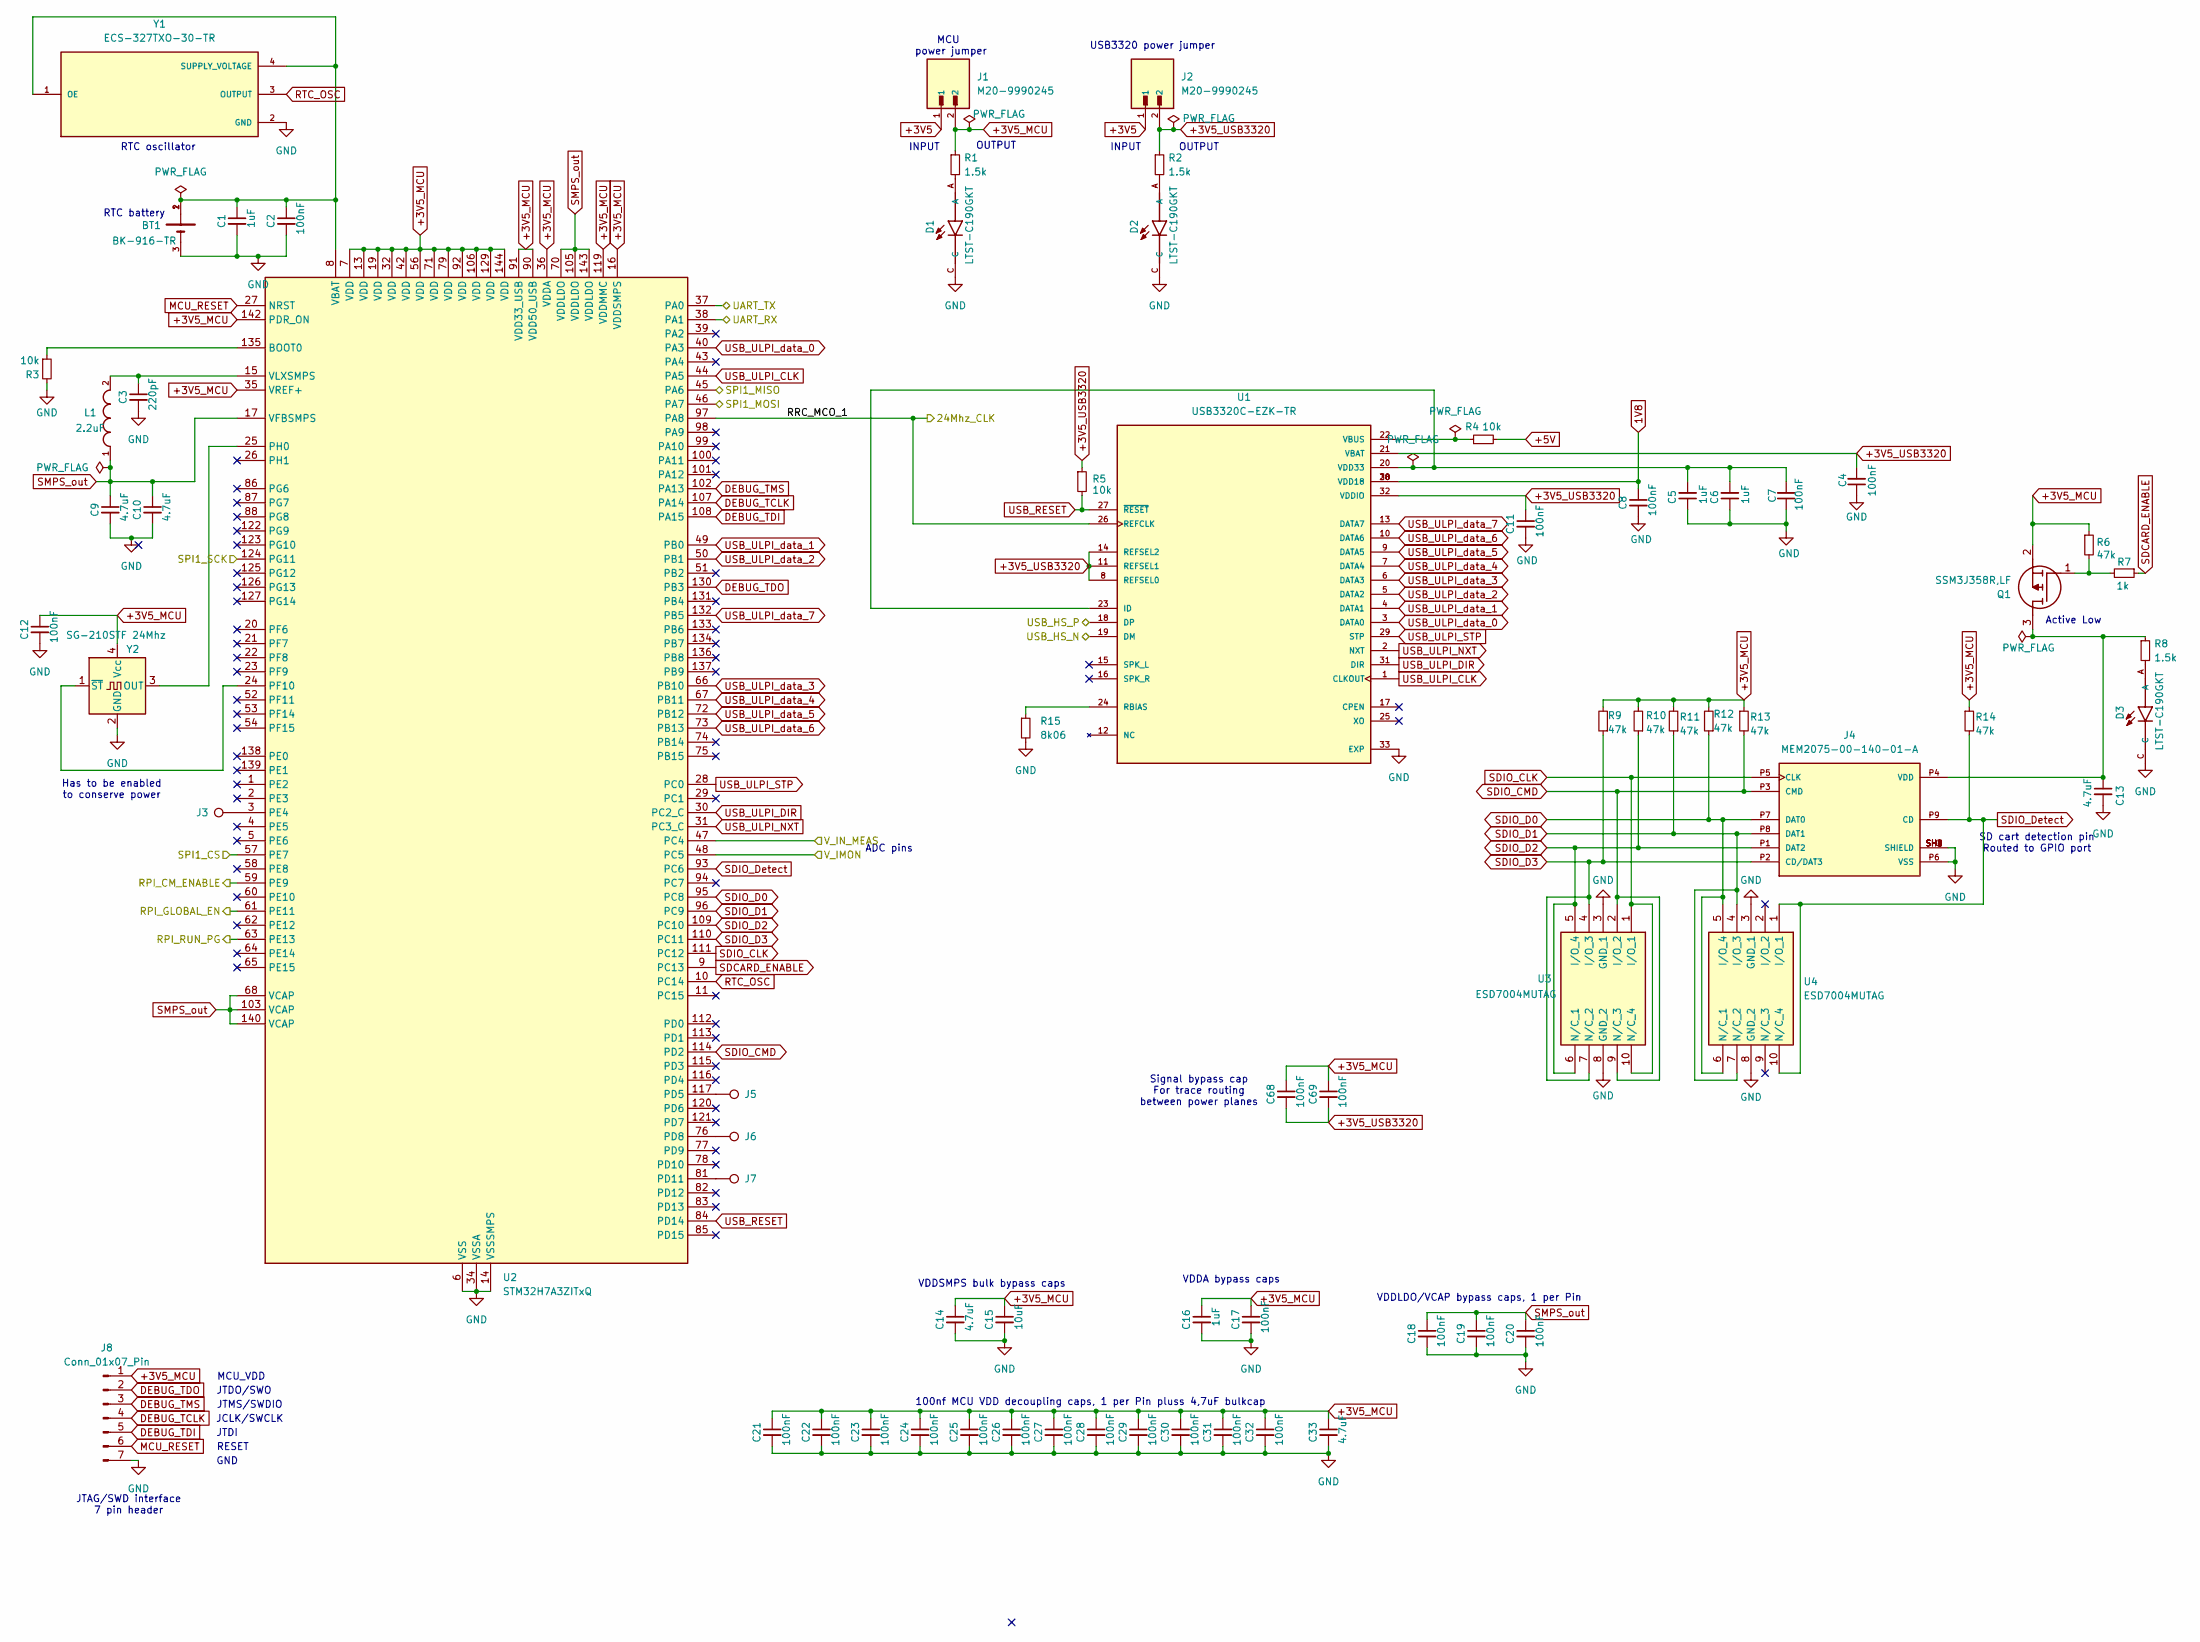
[picture p23: schematic Microcontroller.kicad_sch]

Parts:
BT1: BK-916-TR; BAT_BK-916-TR; PARTREV A
C1, C5, C6, C16: 1uF; C_0603_1608Metric; Voltage rating 16v; Part-no CL10B105KO8NNNC
C2, C4, C7, C8, C11, C12, C17, C18, C19, C20, C21, C22, C23, C24, C25, C26, C27, C28, C29, C30, C31, C32, C68, C69: 100nF; C_0603_1608Metric; Voltage rating 50v; Part-no CL10B104KB8NNWC
C3: 220pF; C_0603_1608Metric; Voltage rating 50v; Part-no C0603C221J5GAC7411
C9, C10, C13, C14, C33: 4.7uF; C_0805_2012Metric; Voltage rating 25v; Part-no CL21A475KAQNNNE
C15: 10uF; C_1206_3216Metric; Voltage rating 50v; Part-no CL31B106KBHNNNE
D1, D2, D3: LTST-C190GKT; LEDM1608X80; Part-no LTST-C190GKT
J1, J2: M20-9990245; HARWIN_M20-9990245; PARTREV 14
J3, J5, J6, J7: TestPoint_Pad_D1.0mm
J4: MEM2075-00-140-01-A; GCT_MEM2075-00-140-01-A; PARTREV A
J8: Conn_01x07_Pin; PinHeader_1x07_P2.54mm_Vertical
L1: 2.2uF; INDC2520X120N; Part-no DFE252012P-2R2M=P2
Q1: SSM3J358R,LF; SOTFL95P240X88-3N; Manufacturer_Part_Number SSM3J358R,LF; Mouser Part Number 757-SSM3J358RLF
R1, R2, R8: 1.5k; R_0603_1608Metric
R3, R4, R5: 10k; R_0603_1608Metric; Part-no RC0603FR-0710KL
R6, R9, R10, R11, R12, R13, R14: 47k; R_0603_1608Metric
R7: 1k; R_0603_1608Metric
R15: 8k06; R_0603_1608Metric
U1: USB3320C-EZK-TR; QFN50P500X500X100-33N; PARTREV 05-31-16
U2: STM32H7A3ZITxQ; LQFP-144_20x20mm_P0.5mm; Part-no STM32H7A3ZIT6Q
U3, U4: ESD7004MUTAG; UDFN10_CASE_517BB; Manufacturer_Part_Number ESD7004MUTAG; Mouser Part Number 863-ESD7004MUTAG
Y1: ECS-327TXO-30-TR; OSC_ECS-327TXO-30-TR; PARTREV Rev.2019
Y2: SG-210STF 24Mhz; Oscillator_SMD_SeikoEpson_SG210-4Pin_2.5x2.0mm; Part-no SG-210STF 24Mhz

Connections:
1V8: C8.1, U1.28 (VDD18), U1.30 (VDD18); also elsewhere on the board
+3V5: J1.1, J2.1; also elsewhere on the board
+3V5_MCU: C12.1, C14.1, C15.1, C16.1, C17.1, C21.1, C22.1, C23.1, C24.1, C25.1, C26.1, C27.1, C28.1, C29.1, C30.1, C31.1, C32.1, C33.1, C68.1, C69.1, J1.2, J8.1, Q1.2 (S), R1.1, R6.1, R9.2, R10.2, R11.2, R12.2, R13.1, R14.1, U2.7 (VDD), U2.13 (VDD), U2.16 (VDDSMPS), U2.19 (VDD), U2.32 (VDD), U2.35 (VREF+), U2.36 (VDDA), U2.42 (VDD), U2.56 (VDD), U2.71 (VDD), U2.79 (VDD), U2.90 (VDD50_USB), U2.91 (VDD33_USB), U2.92 (VDD), U2.106 (VDD), U2.119 (VDDMMC), U2.129 (VDD), U2.142 (PDR_ON), U2.144 (VDD), Y2.4 (Vcc)
+3V5_USB3320: C4.2, C11.1, C68.2, C69.2, J2.2, R2.1, R5.1, U1.8 (REFSEL0), U1.11 (REFSEL1), U1.14 (REFSEL2), U1.21 (VBAT), U1.32 (VDDIO)
+5V: R4.2; also elsewhere on the board
/Microcontroller/RPI_CM_ENABLE: U2.59 (PE9); also elsewhere on the board
/Microcontroller/RPI_GLOBAL_EN: U2.61 (PE11); also elsewhere on the board
/Microcontroller/RPI_RUN_PG: U2.63 (PE13); also elsewhere on the board
/Microcontroller/RRC_MCO_1: U1.26 (REFCLK), U2.97 (PA8); also elsewhere on the board
/Microcontroller/UART_RX: U2.38 (PA1); also elsewhere on the board
/Microcontroller/UART_TX: U2.37 (PA0); also elsewhere on the board
/Microcontroller/USB_HS_N: U1.19 (DM); also elsewhere on the board
/Microcontroller/USB_HS_P: U1.18 (DP); also elsewhere on the board
/Microcontroller/V_IMON: U2.48 (PC5); also elsewhere on the board
/Microcontroller/V_IN_MEAS: U2.47 (PC4); also elsewhere on the board
DEBUG_TCLK: J8.4, U2.107 (PA14)
DEBUG_TDI: J8.5, U2.108 (PA15)
DEBUG_TDO: J8.2, U2.130 (PB3)
DEBUG_TMS: J8.3, U2.102 (PA13)
GND: BT1.3, C1.2, C2.2, C3.2, C4.1, C5.1, C6.1, C7.1, C8.2, C9.2, C10.2, C11.2, C12.2, C13.2, C14.2, C15.2, C16.2, C17.2, C18.2, C19.2, C20.2, C21.2, C22.2, C23.2, C24.2, C25.2, C26.2, C27.2, C28.2, C29.2, C30.2, C31.2, C32.2, C33.2, D1.C, D2.C, D3.C, J4.P6 (VSS), J4.SH1 (SHIELD), J4.SH2 (SHIELD), J4.SH3 (SHIELD), J4.SH4 (SHIELD), J8.7, R3.2, R15.2, U1.33 (EXP), U2.6 (VSS), U2.12 (VSS), U2.14 (VSSSMPS), U2.18 (VSS), U2.33 (VSS), U2.34 (VSSA), U2.41 (VSS), U2.55 (VSS), U2.69 (VSS), U2.80 (VSS), U2.89 (VSS), U2.104 (VSS), U2.118 (VSS), U2.128 (VSS), U2.141 (VSS), U3.3 (GND_1), U3.8 (GND_2), U4.3 (GND_1), U4.8 (GND_2), Y1.2 (GND), Y2.2 (GND); also elsewhere on the board
MCU_RESET: J8.6, U2.27 (NRST)
unnamed: D1.A, R1.2
unnamed: D2.A, R2.2
unnamed: D3.A, R8.2
unnamed: C13.1, J4.P4 (VDD), Q1.3 (D), R8.1
unnamed: Q1.1 (G), R6.2, R7.2
unnamed: C5.2, C6.2, C7.2, U1.20 (VDD33), U1.23 (ID)
unnamed: R15.1, U1.24 (RBIAS)
unnamed: R4.1, U1.22 (VBUS)
unnamed: R3.1, U2.135 (BOOT0)
unnamed: J5.1, U2.117 (PD5)
unnamed: J6.1, U2.76 (PD8)
unnamed: J7.1, U2.81 (PD11)
unnamed: J3.1, U2.3 (PE4)
unnamed: U2.24 (PF10), Y2.1 (~ST)
unnamed: U2.25 (PH0), Y2.3 (OUT)
unnamed: BT1.1, BT1.2, C1.1, C2.1, U2.8 (VBAT), Y1.1 (OE), Y1.4 (SUPPLY_VOLTAGE)
unnamed: C3.1, L1.2, U2.15 (VLXSMPS)
RTC_OSC: U2.10 (PC14), Y1.3 (OUTPUT)
SD-pin2: U2.57 (PE7); also elsewhere on the board
SD-pin3: U2.46 (PA7); also elsewhere on the board
SD-pin5: U2.124 (PG11); also elsewhere on the board
SD-pin7: U2.45 (PA6); also elsewhere on the board
SDCARD_ENABLE: R7.1, U2.9 (PC13)
SDIO_CLK: J4.P5 (CLK), U2.111 (PC12), U3.1 (I/O_1), U3.10 (N/C_4)
SDIO_CMD: J4.P3 (CMD), R13.2, U2.114 (PD2), U3.2 (I/O_2), U3.9 (N/C_3)
SDIO_D0: J4.P7 (DAT0), R12.1, U2.95 (PC8), U4.5 (I/O_4), U4.6 (N/C_1)
SDIO_D1: J4.P8 (DAT1), R11.1, U2.96 (PC9), U4.4 (I/O_3), U4.7 (N/C_2)
SDIO_D2: J4.P1 (DAT2), R10.1, U2.109 (PC10), U3.5 (I/O_4), U3.6 (N/C_1)
SDIO_D3: J4.P2 (CD/DAT3), R9.1, U2.110 (PC11), U3.4 (I/O_3), U3.7 (N/C_2)
SDIO_Detect: J4.P9 (CD), R14.2, U2.93 (PC6), U4.1 (I/O_1), U4.10 (N/C_4)
SMPS_out: C9.1, C10.1, C18.1, C19.1, C20.1, L1.1, U2.17 (VFBSMPS), U2.68 (VCAP), U2.70 (VDDLDO), U2.103 (VCAP), U2.105 (VDDLDO), U2.140 (VCAP), U2.143 (VDDLDO)
USB_RESET: R5.2, U1.27 (~RESET), U2.84 (PD14)
USB_ULPI_CLK: U1.1 (CLKOUT), U2.44 (PA5)
USB_ULPI_DIR: U1.31 (DIR), U2.30 (PC2_C)
USB_ULPI_NXT: U1.2 (NXT), U2.31 (PC3_C)
USB_ULPI_STP: U1.29 (STP), U2.28 (PC0)
USB_ULPI_data_0: U1.3 (DATA0), U2.40 (PA3)
USB_ULPI_data_1: U1.4 (DATA1), U2.49 (PB0)
USB_ULPI_data_2: U1.5 (DATA2), U2.50 (PB1)
USB_ULPI_data_3: U1.6 (DATA3), U2.66 (PB10)
USB_ULPI_data_4: U1.7 (DATA4), U2.67 (PB11)
USB_ULPI_data_5: U1.9 (DATA5), U2.72 (PB12)
USB_ULPI_data_6: U1.10 (DATA6), U2.73 (PB13)
USB_ULPI_data_7: U1.13 (DATA7), U2.132 (PB5)

Notes on the sheet:
JTDI
INPUT
SD cart detection pin Routed to GPIO port
RTC oscillator
MCU_VDD
JCLK/SWCLK
OUTPUT
ADC pins
VDDLDO/VCAP bypass caps, 1 per Pin
Signal bypass cap For trace routing between power planes
RESET
Has to be enabled to conserve power
JTDO/SWO
Active Low
100nf MCU VDD decoupling caps, 1 per Pin pluss 4,7uF bulkcap
GND
RTC battery
VDDA bypass caps
JTAG/SWD interface 7 pin header
USB3320 power jumper
MCU power jumper
VDDSMPS bulk bypass caps
JTMS/SWDIO

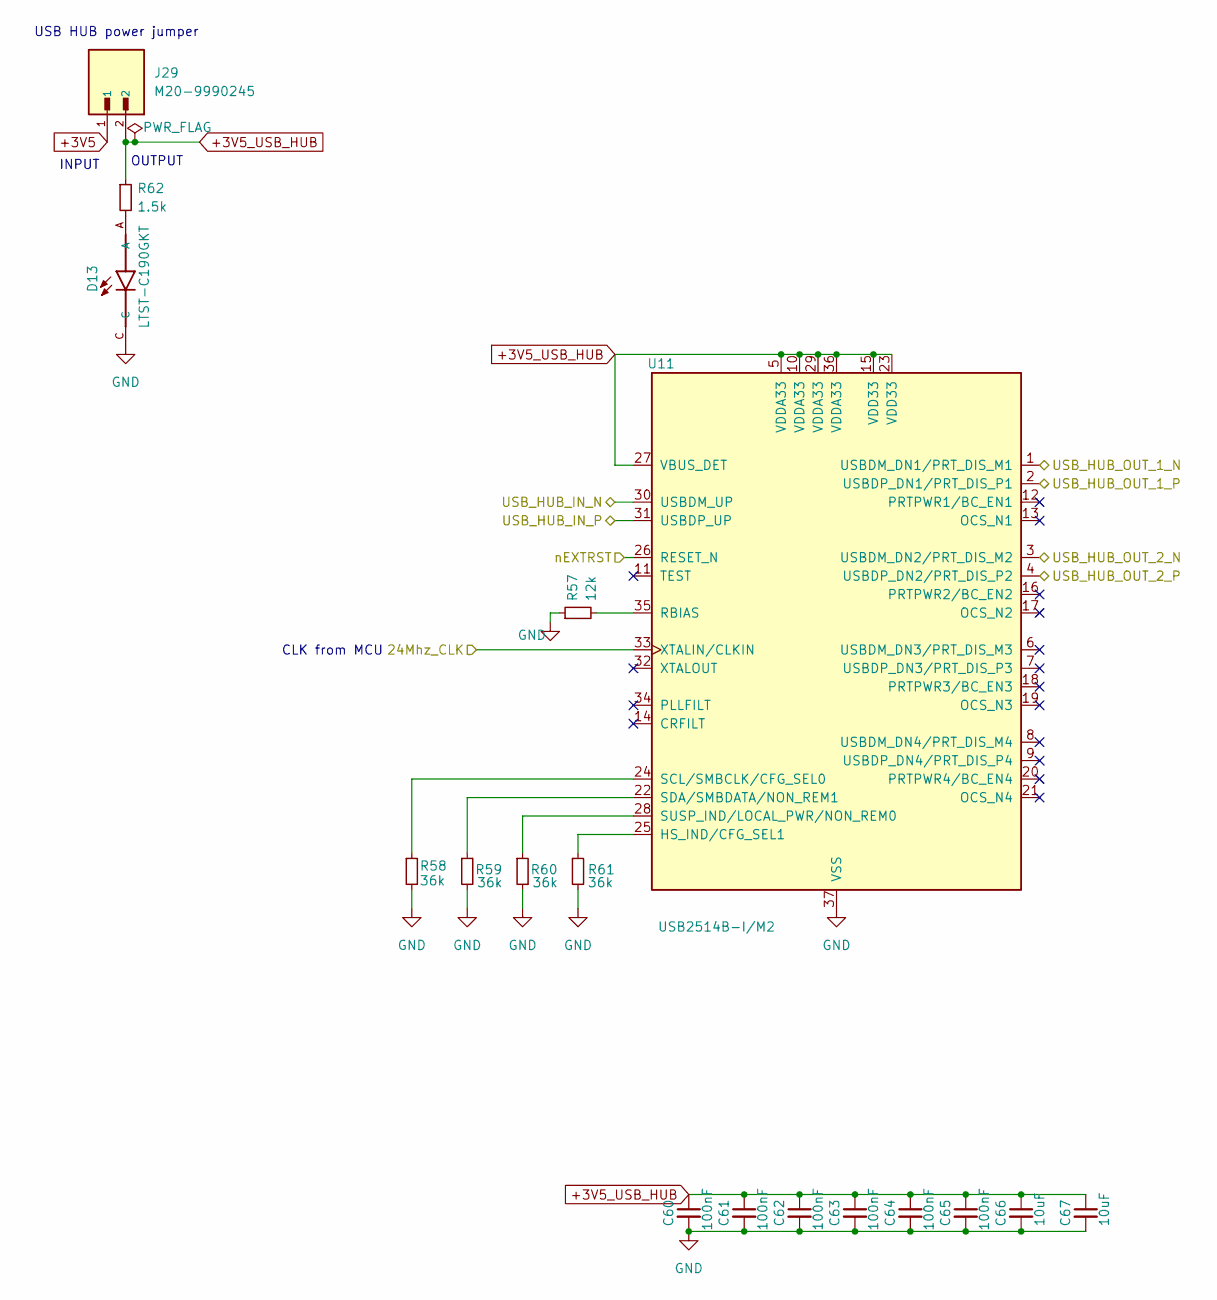
[picture p24: schematic USB_HUB.kicad_sch]

Parts:
C60, C61, C62, C63, C64, C65: 100nF; C_0603_1608Metric; Voltage rating 50v; Part-no CL10B104KB8NNWC
C66, C67: 10uF; C_1206_3216Metric; Voltage rating 50v; Part-no CL31B106KBHNNNE
D13: LTST-C190GKT; LEDM1608X80; Part-no LTST-C190GKT
J29: M20-9990245; HARWIN_M20-9990245; PARTREV 14
R57: 12k; R_0603_1608Metric
R58, R59, R60, R61: 36k; R_0603_1608Metric
R62: 1.5k; R_0603_1608Metric
U11: USB2514B-I/M2; QFN-36-1EP_6x6mm_P0.5mm_EP3.7x3.7mm; Part Description USB Hub Controller USB Interface 36-SQF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

Connections:
+3V5: J29.1; also elsewhere on the board
+3V5_USB_HUB: C60.1, C61.1, C62.1, C63.1, C64.1, C65.1, C66.1, C67.1, J29.2, R62.1, U11.5 (VDDA33), U11.10 (VDDA33), U11.15 (VDD33), U11.23 (VDD33), U11.27 (VBUS_DET), U11.29 (VDDA33), U11.36 (VDDA33)
/Microcontroller/RRC_MCO_1: U11.33 (XTALIN/CLKIN); also elsewhere on the board
/Microcontroller/USB_HS_N: U11.1 (USBDM_DN1/PRT_DIS_M1); also elsewhere on the board
/Microcontroller/USB_HS_P: U11.2 (USBDP_DN1/PRT_DIS_P1); also elsewhere on the board
/Raspberry Pi CM 4/USB_HS_N: U11.30 (USBDM_UP); also elsewhere on the board
/Raspberry Pi CM 4/USB_HS_P: U11.31 (USBDP_UP); also elsewhere on the board
/Raspberry Pi CM 4/nEXTRST: U11.26 (RESET_N); also elsewhere on the board
/USB Hub/USB_HUB_OUT_2_N: U11.3 (USBDM_DN2/PRT_DIS_M2); also elsewhere on the board
/USB Hub/USB_HUB_OUT_2_P: U11.4 (USBDP_DN2/PRT_DIS_P2); also elsewhere on the board
GND: C60.2, C61.2, C62.2, C63.2, C64.2, C65.2, C66.2, C67.2, D13.C, R57.1, R58.2, R59.2, R60.2, R61.2, U11.37 (VSS); also elsewhere on the board
unnamed: D13.A, R62.2
unnamed: R61.1, U11.25 (HS_IND/CFG_SEL1)
unnamed: R57.2, U11.35 (RBIAS)
unnamed: R58.1, U11.24 (SCL/SMBCLK/CFG_SEL0)
unnamed: R59.1, U11.22 (SDA/SMBDATA/NON_REM1)
unnamed: R60.1, U11.28 (SUSP_IND/LOCAL_PWR/NON_REM0)

Notes on the sheet:
CLK from MCU
OUTPUT
INPUT
USB HUB power jumper

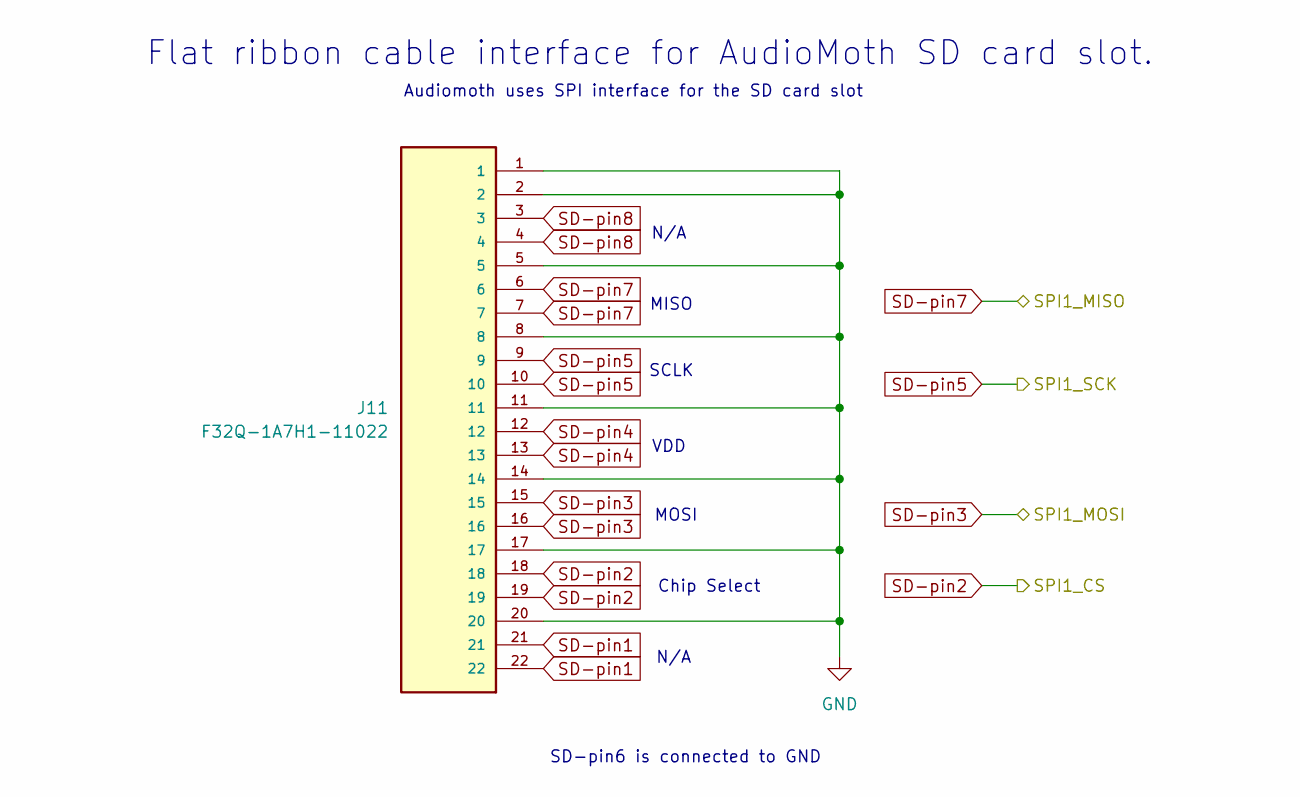
[picture p25: schematic SD-Card_interface.kicad_sch]

Parts:
J11: F32Q-1A7H1-11022; AMPHENOL_F32Q-1A7H1-11022; PARTREV D

Connections:
GND: J11.1, J11.2, J11.5, J11.8, J11.11, J11.14, J11.17, J11.20; also elsewhere on the board
SD-pin1: J11.21, J11.22
SD-pin2: J11.18, J11.19; also elsewhere on the board
SD-pin3: J11.15, J11.16; also elsewhere on the board
SD-pin4: J11.12, J11.13
SD-pin5: J11.9, J11.10; also elsewhere on the board
SD-pin7: J11.6, J11.7; also elsewhere on the board
SD-pin8: J11.3, J11.4

Notes on the sheet:
VDD
Flat ribbon cable interface for AudioMoth SD card slot.
SCLK
N/A
N/A
MISO
Chip Select
MOSI
Audiomoth uses SPI interface for the SD card slot
SD-pin6 is connected to GND

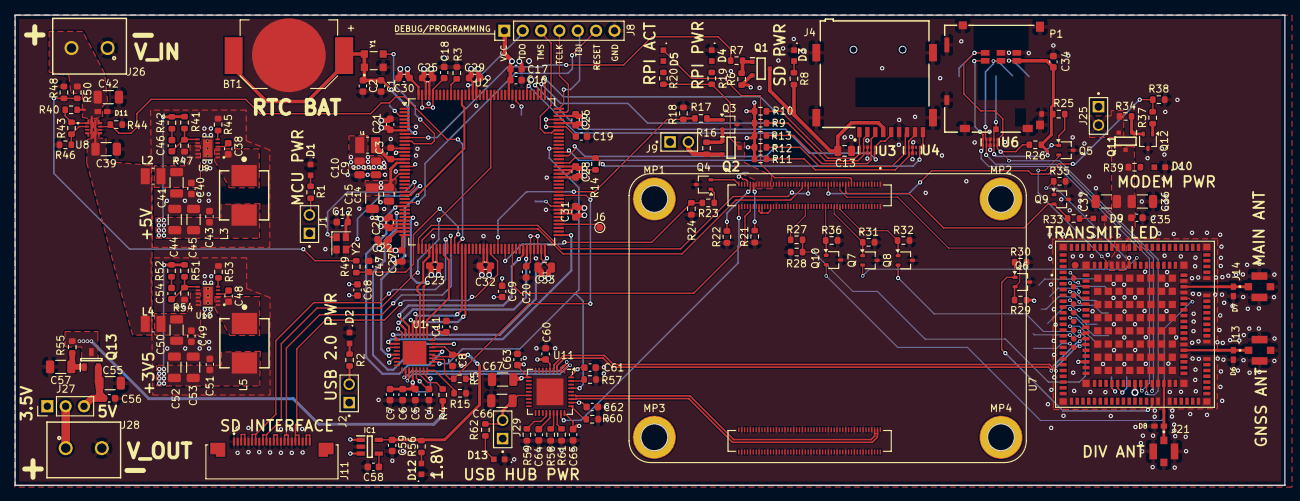
[picture p26: board Bachelor_Main_PCB.kicad_pcb from above]

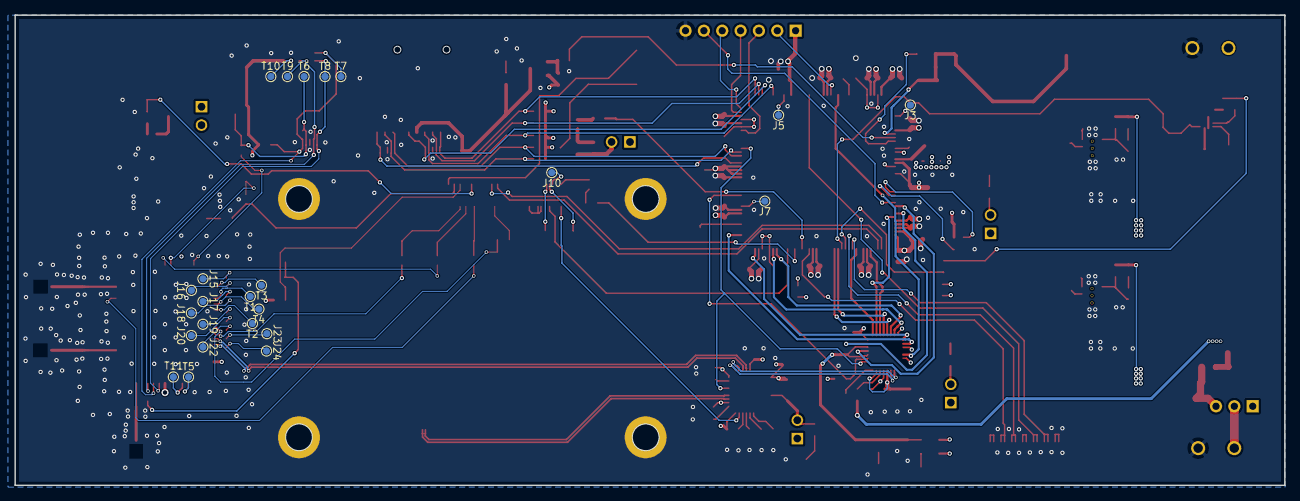
[picture p27: board Bachelor_Main_PCB.kicad_pcb from below]

Board: 4 copper layers, 175.8 x 65.1 mm, 224 parts (24 on the bottom side), 161 nets.
