fiskebolle30/Bachelor_Electronics_hardware/(commit log)

2025-03-04 innitial creation of KiCad project
    With 1 resistor 0603 standard size to be used
    [Bachelor_Main_PCB.kicad_pcb, Bachelor_Main_PCB.kicad_sch]
2025-03-14 Add Ribon cable connector
    F32Q-1A7H1-11022
    [Bachelor_Main_PCB.kicad_sch, F32Q-1A7H1-11022.step]
2025-03-14 Add RPI cm and route all Ribon cable pins correctly
    [Bachelor_Main_PCB.kicad_pcb, Bachelor_Main_PCB.kicad_sch]
2025-03-14 Updated ribon cable pins
    [Bachelor_Main_PCB.kicad_sch]
2025-03-17 Add GND to RPI CM
    [Bachelor_Main_PCB.kicad_sch]
2025-03-17 Add Spacers for RPI CM and created separate hierarchical sheets
    [Bachelor_Main_PCB.kicad_pcb, Bachelor_Main_PCB.kicad_sch, Microcontroller.kicad_sch, Raspbery_Pi_CM_4.kicad_sch, SD-Card_interface.kicad_sch, WA-SMSI_9774XXX151.step]
2025-03-17 Add Sierra Wireless modem and 100pin RPI CM connectors
    [Bachelor_Main_PCB.kicad_pcb, Bachelor_Main_PCB.kicad_sch, Microcontroller.kicad_sch, Raspbery_Pi_CM_4.kicad_sch, SD-Card_interface.kicad_sch, Wireless_modem.kicad_sch]
2025-03-17 Fix 100 pin RPI CM connector 3D model
    part of RPI CM 3d model now
    [Microcontroller.kicad_sch, Raspbery_Pi_CM_4.kicad_sch, SD-Card_interface.kicad_sch, Wireless_modem.kicad_sch]
2025-03-19 Add STM32 and 3d model. Made power suply sheet
    [Bachelor_Main_PCB.kicad_pcb, Bachelor_Main_PCB.kicad_sch, Microcontroller.kicad_sch, Wireless_modem.kicad_sch]
2025-03-19 Small changes
    Just moved some components
    [Bachelor_Main_PCB.kicad_sch, Power_supply.kicad_sch]
2025-03-21 Add STM32 3D modell
    [Bachelor_Main_PCB.kicad_pcb]
2025-03-24 Add SIM card holder
    [Wireless_modem.kicad_sch]
2025-03-24 småtteri
    [Wireless_modem.kicad_sch]
2025-03-24 Add USB-Tranciever
    [Bachelor_Main_PCB.kicad_pcb, Microcontroller.kicad_sch, USB3320C-EZK-TR.step]
2025-03-25 ULPI global lables
    [Microcontroller.kicad_sch]
2025-03-25 Routed all 12ULPI pins to MCU
    [Microcontroller.kicad_sch]
2025-03-26 Add Y1 oscillator to the USB3320
    24Mhz oscillator for the USB tranciever
    [Bachelor_Main_PCB.kicad_pcb, Microcontroller.kicad_sch, SG-210STF_1.2000ML.step]
2025-03-28 Add Bypass cap USB3320
    [Microcontroller.kicad_sch]
2025-03-28 Routing some MCU pins
    [Microcontroller.kicad_sch]
2025-03-28 Add more bypass caps
    [Microcontroller.kicad_sch]
2025-03-31 Fix bypass cap routing
    [Microcontroller.kicad_sch]
2025-03-31 Add Rbias resisstor to USB3320
    [Microcontroller.kicad_sch]
2025-03-31 Route ID pin on USB3320, Fix 0603 footprint on resistors
    [Bachelor_Main_PCB.kicad_sch, Microcontroller.kicad_sch]
2025-03-31 Add RPI_5v pin
    [Microcontroller.kicad_sch]
2025-03-31 USB3320 CPEN is NC!
    [Microcontroller.kicad_sch]
2025-03-31 Add USB3320 Reset pin pullup
    [Microcontroller.kicad_sch]
2025-03-31 USB3320 Reset connected to PD14
    [Microcontroller.kicad_sch]
2025-03-31 Route RPI USB
    PS: we need a USB hub
    [Bachelor_Main_PCB.kicad_sch, Raspbery_Pi_CM_4.kicad_sch]
2025-04-01 Add 1x2header library
    [M20-9990245.step]
2025-04-01 Add MCU, USB3320 and USB_HUB power jumpers
    [Microcontroller.kicad_sch]
2025-04-01 Add 2,2uF inductor to MCU
    [DFE252012P-2R2M_P2.step, Microcontroller.kicad_sch]
2025-04-01 Add MCU VDD caps
    [Microcontroller.kicad_sch]
2025-04-01 Add SMPS circuit
    [Microcontroller.kicad_sch]
2025-04-01 VDDLDO add bypass caps
    [Microcontroller.kicad_sch]
2025-04-02 Add more bypass caps to MCU
    [Microcontroller.kicad_sch]
2025-04-02 add BK-916 rtc battery holder
    [BK-916-TR.step, Microcontroller.kicad_sch]
2025-04-02 VDDUSB headers together
    [Microcontroller.kicad_sch]
2025-04-02 PDR_on to VDD
    [Microcontroller.kicad_sch]
2025-04-04 Add RTC oscillator
    [ECS-327TXO-33-TR.step, Microcontroller.kicad_sch]
2025-04-04 ADD JTAG 7pin header
    [Microcontroller.kicad_sch]
2025-04-07 Renamed JTAG_ pins to DEBUG_
    Due to it being both JTAG and SWD (serial wire debug)
    [Microcontroller.kicad_sch]
2025-04-07 More concise labeling of DEBUG pins
    [Microcontroller.kicad_sch]
2025-04-07 MODEM power connections
    [Microcontroller.kicad_sch, Wireless_modem.kicad_sch]
2025-04-07 Add MODEM testpoints
    [Wireless_modem.kicad_sch]
2025-04-07 Add SIM card circuit and ESD supression
    [EDI2CAP.CFG, ESD7004MUTAG.stp, Wireless_modem.kicad_sch, chips.prt]
2025-04-07 Fix anotation of "J" designators and routed ESD suppression on Modem
    [Microcontroller.kicad_sch, SD-Card_interface.kicad_sch, Wireless_modem.kicad_sch]
2025-04-07 ADD mosfet controls from BUGG MODEM
    [Wireless_modem.kicad_sch]
2025-04-07 Add all MODEM signals
    [Microcontroller.kicad_sch, Wireless_modem.kicad_sch]
2025-04-07 Add modem safe power remove
    [Microcontroller.kicad_sch, Wireless_modem.kicad_sch]
2025-04-07 Route all MODEM to RPI pins (except USB HS)
    [Bachelor_Main_PCB.kicad_sch, Raspbery_Pi_CM_4.kicad_sch]
2025-04-07 Add routing between hierarchal sheets modem and RPI
    [Bachelor_Main_PCB.kicad_sch, Microcontroller.kicad_sch, Wireless_modem.kicad_sch]
2025-04-07 Switched 3,3 for 3,5_MODEM for Q11 and Q9 circuits
    [Wireless_modem.kicad_sch]
2025-04-08 Add MODEM_3V5_EN mosfet
    Controlls the power supply to the modem from the RPI GPIO7
    [Bachelor_Main_PCB.kicad_sch, EDI2CAP.CFG, Microcontroller.kicad_sch, PMV13XNEAR.stp, Raspbery_Pi_CM_4.kicad_sch, Wireless_modem.kicad_sch, chips.prt, sot95p230x110-3n.psm]
2025-04-08 Change MODEM_3V5_EN mosfet to P-channel type SSM3j358R
    [EDI2CAP.CFG, PMV13XNEAR.stp, SSM3J358R,LF.stp, Wireless_modem.kicad_sch, chips.prt, sot95p230x110-3n.psm, sotfl95p240x88-3n.psm]
2025-04-08 ADD MODEM_3V5_EN signal inverter
    [Wireless_modem.kicad_sch]
2025-04-08 Renamed wring MODEM_3V7_en to 3V5
    [Bachelor_Main_PCB.kicad_sch, Raspbery_Pi_CM_4.kicad_sch, Wireless_modem.kicad_sch]
2025-04-08 Add USB HUB of type USB2514B-i/M2
    Same as RPI CM 4 IO board
    [Bachelor_Main_PCB.kicad_sch, USB_HUB.kicad_sch]
2025-04-08 Add Vcc to Y1
    [Bachelor_Main_PCB.kicad_sch, Microcontroller.kicad_sch, USB_HUB.kicad_sch]
2025-04-08 Add 24Mhz clock to USB hub. same as USB tranciever
    [USB_HUB.kicad_sch]
2025-04-08 Add HUB bypass caps
    [USB_HUB.kicad_sch]
2025-04-09 ADD USBHUB Reset pin
    [Raspbery_Pi_CM_4.kicad_sch, USB_HUB.kicad_sch]
2025-04-09 USB HUB done
    [USB_HUB.kicad_sch]
2025-04-09 Fix hierarchal sheet naming for USB hub
    [Bachelor_Main_PCB.kicad_sch, USB_HUB.kicad_sch]
2025-04-09 Routed Sheeets
    [Bachelor_Main_PCB.kicad_sch, USB_HUB.kicad_sch, Wireless_modem.kicad_sch]
2025-04-09 Add SD CARD pullups
    [Bachelor_Main_PCB.kicad_sch, MEM2075-00-140-01-A.step, Microcontroller.kicad_sch, SD-Card_interface.kicad_sch, USB_HUB.kicad_sch]
2025-04-09 SD CARD ESD TVS Diodes
    [Microcontroller.kicad_sch, USB_HUB.kicad_sch]
2025-04-09 Updated TVS diode routing through N/C pins
    [Bachelor_Main_PCB.kicad_sch, USB_HUB.kicad_sch, Wireless_modem.kicad_sch]
2025-04-09 Add cdcard to MCU connections(except detect pin)
    [Microcontroller.kicad_sch, USB_HUB.kicad_sch]
2025-04-09 MAIN_RF TVS diode and routed SDIO_DETECT
    [0402ESDA-MLP1.step, Microcontroller.kicad_sch, USB_HUB.kicad_sch, Wireless_modem.kicad_sch]
2025-04-09 ADD UFL antenna connectors
    [CONMHF1-SMD-G-T.step, USB_HUB.kicad_sch, Wireless_modem.kicad_sch]
2025-04-09 Started on PSU sheet
    [Power_supply.kicad_sch, USB_HUB.kicad_sch]
2025-04-11 Add GNSS antenna Connector
    Which is DNP but can be nice in future revision/ implementation
    [USB_HUB.kicad_sch, Wireless_modem.kicad_sch]
2025-04-11 add LM 73100 ideal diode
    [LM73100RPWR.step, Power_supply.kicad_sch, USB_HUB.kicad_sch]
2025-04-11 Added RIMON + R1,R2,R3 to Ideal diode circuit
    [Power_supply.kicad_sch, USB_HUB.kicad_sch]
2025-04-12 Add RPI to MCU UART communication
    [Bachelor_Main_PCB.kicad_sch, Microcontroller.kicad_sch, Power_supply.kicad_sch, Raspbery_Pi_CM_4.kicad_sch, USB_HUB.kicad_sch]
2025-04-12 Add RPI power Switch MOSFET, Fix direction of power switch MOSFETs
    [Raspbery_Pi_CM_4.kicad_sch, USB_HUB.kicad_sch, Wireless_modem.kicad_sch]
2025-04-12 Switched RX and TX for UART connection
    so that the TX from RPI go into RX on MCU
    [Bachelor_Main_PCB.kicad_sch, Raspbery_Pi_CM_4.kicad_sch, USB_HUB.kicad_sch]
2025-04-12 Add 1,8v regulator
    LD3985M18R
    [EDI2CAP.CFG, LD3985M18R.stp, Microcontroller.kicad_sch, Power_supply.kicad_sch, USB_HUB.kicad_sch, chips.prt, sot95p280x145-5n.psm]
2025-04-12 updated 1,8v global lables
    [Microcontroller.kicad_sch, Power_supply.kicad_sch, USB_HUB.kicad_sch]
2025-04-12 Added text to SD audiomoth interface
    [SD-Card_interface.kicad_sch, USB_HUB.kicad_sch]
2025-04-13 Make correct stackup and add 90ohm differential pair usb
    [Bachelor_Main_PCB.kicad_pcb, Raspbery_Pi_CM_4.kicad_sch, Wireless_modem.kicad_sch]
2025-04-13 Made corecct 90ohm diff pair net settings
    Calculated with Saturn PCB toolkit. Width 0.23 and space 1,5
    [Bachelor_Main_PCB.kicad_pcb]
2025-04-13 Make all usb lines part of DP_90ohm nettclass
    [Microcontroller.kicad_sch, USB_HUB.kicad_sch]
2025-04-13 made Antenna Waveguide net and attached the antenna connectors
    [Wireless_modem.kicad_sch]
2025-04-13 55ohm ULPI Net made and assigned
    [Microcontroller.kicad_sch]
2025-04-13 Add RPI CM enable pin to MCU sheet
    [Bachelor_Main_PCB.kicad_sch, Microcontroller.kicad_sch, Raspbery_Pi_CM_4.kicad_sch]
2025-04-13 Add SDcard enable VCC pin with PMOS
    [Microcontroller.kicad_sch, Raspbery_Pi_CM_4.kicad_sch]
2025-04-13 Fixed schematic of SDcard enable pin
    [Microcontroller.kicad_sch, Wireless_modem.kicad_sch]
2025-04-14 Add audiomoth to MCU SPI
    [Bachelor_Main_PCB.kicad_sch, Microcontroller.kicad_sch, SD-Card_interface.kicad_sch]
2025-04-14 Add Vin sampling and route V_IN and V_IMON to MCU sheet
    [Bachelor_Main_PCB.kicad_sch, Microcontroller.kicad_sch, Power_supply.kicad_sch, SD-Card_interface.kicad_sch]
2025-04-14 add PC4 and PC5 as V_IN and V_IMON
    [Microcontroller.kicad_sch]
2025-04-14 Add LMR51450 switch mode regulator.
    [LMR51450FNDRRR.step, Power_supply.kicad_sch]
2025-04-14 Remove RPI CM power on mosfet. Replaced with EN pin to PSU
    the pin is now routed instead to the LMR51450 converter ENABLE pin.
    [Bachelor_Main_PCB.kicad_sch, Power_supply.kicad_sch, Raspbery_Pi_CM_4.kicad_sch]
2025-04-14 add pulldown to PSU EN pin
    [Power_supply.kicad_sch]
2025-04-14 Add voltage select divider
    [Power_supply.kicad_sch]
2025-04-14 add 4,7uH switchmode inductor
    [Power_supply.kicad_sch, WE-LHMI_7050.step]
2025-04-14 add 3,3uH inductor for 3,5v and add Rff and Cff to FB pin
    [Power_supply.kicad_sch, WE-LHMI_7050_3uH3.step]
2025-04-14 Add series inductors to switch mode convertors. Add screw terminal
    For the audiomoth power.
    [691137710002.step, LQM2HPN1R0MJHL.step, Power_supply.kicad_sch, Raspbery_Pi_CM_4.kicad_sch]
2025-04-15 Reinstated Mosfet RPI_CM_ENABLE controll
    instead of enable pin on switch mode controller. this way the audiomoth can use the 5v supply with the capacitor multiplier.
    [Bachelor_Main_PCB.kicad_sch, Power_supply.kicad_sch, Raspbery_Pi_CM_4.kicad_sch]
2025-04-15 Add BC817 and complete capacitance multiplier
    [BC817-40Q-13-F.stp, EDI2CAP.CFG, Power_supply.kicad_sch, chips.prt, sot96p240x110-3n.psm]
2025-04-15 Add green led to all power rails
    [LTST-C190GKT.step, Microcontroller.kicad_sch, Power_supply.kicad_sch, Raspbery_Pi_CM_4.kicad_sch]
2025-04-15 add more LEDs
    [Wireless_modem.kicad_sch]
2025-04-15 connect RPI GPIO_VREF to internal 3,3v regulator
    [Raspbery_Pi_CM_4.kicad_sch]
2025-04-15 Add LED to SD card vcc pin
    [Microcontroller.kicad_sch]
2025-04-16 Achematic review changes. Smal ones. Replaced TX_ON LED
    [Microcontroller.kicad_sch, Power_supply.kicad_sch, SD-Card_interface.kicad_sch, USB_HUB.kicad_sch, Wireless_modem.kicad_sch]
2025-04-16 Add cap multiplier simulation
    [cap_multiplier_simulation.kicad_pcb, cap_multiplier_simulation.kicad_sch]
2025-04-16 Add 24Mhz to MCU
    [Microcontroller.kicad_sch]
2025-04-16 Routed 24Mhz
    [Microcontroller.kicad_sch]
2025-04-16 added 100nF to 24Mhz oscillators
    [Microcontroller.kicad_sch, USB_HUB.kicad_sch]
2025-04-16 Add 3 pin header to select which PSU for the AudioMoth
    [Power_supply.kicad_sch]
2025-04-16 Add LMR51450FNDRRR chip note
    For the PFM and FPWM modes
    [Power_supply.kicad_sch]
2025-04-16 Changed RTC clock to 3.0v model from 3,3v model
    [ECS-327TXO-30-TR.step, Microcontroller.kicad_sch]
2025-04-17 Add correct 47uF partno and footpring
    [Power_supply.kicad_sch, Wireless_modem.kicad_sch]
2025-04-17 Add correct 10uF partno
    [Microcontroller.kicad_sch, Power_supply.kicad_sch, USB_HUB.kicad_sch]
2025-04-17 EXchange 2,2uF for 2x1uF caps to reduce bom. add 4,7uF partno
    [Microcontroller.kicad_sch]
2025-04-17 Add signal inverter to RPIcm enable pin.
    In order to protect MCU against 5v input on GPIO pin.
    [Microcontroller.kicad_sch, Power_supply.kicad_sch, Raspbery_Pi_CM_4.kicad_sch, Wireless_modem.kicad_sch]
2025-04-17 add 10k to Q3
    [Microcontroller.kicad_sch, Power_supply.kicad_sch]
2025-04-17 add UIM_VCC to UIM_DATA pullout which is DNP
    [Wireless_modem.kicad_sch]
2025-04-17 Add 24Mhz gpio controll
    [Microcontroller.kicad_sch]
2025-04-17 Remove 24Mhz oscillators from hub and tranciever
    Replaced with trace to PA8 pin which is the internaly supplied oscillator from the MCU
    [Bachelor_Main_PCB.kicad_sch, Microcontroller.kicad_sch, USB_HUB.kicad_sch]
2025-04-17 Updated the "Part-no" field in the symbol field table for all components
    [Bachelor_Main_PCB.kicad_sch, Microcontroller.kicad_sch, Power_supply.kicad_sch, Raspbery_Pi_CM_4.kicad_sch, SD-Card_interface.kicad_sch, USB_HUB.kicad_sch, Wireless_modem.kicad_sch]
2025-04-17 All resistors and capacitors correct footprints
    [Microcontroller.kicad_sch, Power_supply.kicad_sch, Raspbery_Pi_CM_4.kicad_sch, USB_HUB.kicad_sch, Wireless_modem.kicad_sch]
2025-04-17 Add 1% tolerance field to high tolerance resistors
    [Bachelor_Main_PCB.kicad_sch, Microcontroller.kicad_sch, Power_supply.kicad_sch, Raspbery_Pi_CM_4.kicad_sch, SD-Card_interface.kicad_sch, USB_HUB.kicad_sch, Wireless_modem.kicad_sch]
2025-04-17 Add Part-no to all caps and replaced 15pF on bugg with 33pF
    [Microcontroller.kicad_sch, Power_supply.kicad_sch, USB_HUB.kicad_sch, Wireless_modem.kicad_sch]
2025-04-17 Add pulldown to power switch mosfets
    [Microcontroller.kicad_sch, Power_supply.kicad_sch, Raspbery_Pi_CM_4.kicad_sch, USB_HUB.kicad_sch, Wireless_modem.kicad_sch]
2025-04-17 Changed ideal diode resistors to 23v cutoff instead of 20v cutoff
    [Power_supply.kicad_sch]
2025-04-17 Add Part-no for all resistors with 1% tolerance
    [Microcontroller.kicad_sch, Power_supply.kicad_sch, Raspbery_Pi_CM_4.kicad_sch, Wireless_modem.kicad_sch]
2025-04-17 Fix resistor nameing
    [Microcontroller.kicad_sch, Power_supply.kicad_sch, Raspbery_Pi_CM_4.kicad_sch, Wireless_modem.kicad_sch]
2025-04-17 Standardized on "." for decimal spaces
    [Microcontroller.kicad_sch, Power_supply.kicad_sch]
2025-04-17 removed old RPI_5v enable
    [Bachelor_Main_PCB.kicad_sch]
2025-04-21 Add boot0 tie to ground and footprint to L1
    [Microcontroller.kicad_sch]
2025-04-21 Add RPI activity led to pin 21
    [Raspbery_Pi_CM_4.kicad_sch]
2025-04-21 Add RPI pins: WL_pins, RUN_PG, RPIBOOT and GLOBAL_EN with a mosfet
    the MOSFET to protect against 5v in to MCU
    [Raspbery_Pi_CM_4.kicad_sch]
2025-04-21 Add RPI_RUNPG and GLOBAL_EN pins to MCU sheet and Root
    [Bachelor_Main_PCB.kicad_sch, Microcontroller.kicad_sch, Raspbery_Pi_CM_4.kicad_sch]
2025-04-21 Fixed DRC, footprints and power flags and no-connect flags
    [Bachelor_Main_PCB.kicad_sch, Microcontroller.kicad_sch, Power_supply.kicad_sch, Raspbery_Pi_CM_4.kicad_sch, USB_HUB.kicad_sch, Wireless_modem.kicad_sch]
2025-04-21 Removed Modem_safe_PWR_remove pin.
    was potential use for the MCU but would require level shifters and would not add any functionality ass the RPI controls the Modem anyway.
    [Bachelor_Main_PCB.kicad_sch, Microcontroller_Backup_test_final_final_v2.1.kicad_sch, Raspbery_Pi_CM_4.kicad_sch, SD-Card_interface.kicad_sch, USB_HUB.kicad_sch, Wireless_modem.kicad_sch]
2025-04-21 Fix all DRC errors and warnings
    except not connected pins still unrouted to MCU
    [Microcontroller.kicad_sch, Power_supply.kicad_sch, Raspbery_Pi_CM_4.kicad_sch, Wireless_modem.kicad_sch]
2025-04-21 Småpirk
    [Microcontroller.kicad_sch]
2025-04-21 Add connections to all MCU unrouted pins
    [Microcontroller.kicad_sch]
2025-04-21 Imported components from schematic to PCB and Reanotat all designators
    THis means every designator is now different and the references made prior no longer applies
    [Bachelor_Main_PCB.kicad_pcb, Microcontroller.kicad_sch, Power_supply.kicad_sch, Raspbery_Pi_CM_4.kicad_sch, SD-Card_interface.kicad_sch, USB_HUB.kicad_sch, Wireless_modem.kicad_sch]
2025-04-21 Added 3d model to sd card slot
    [Bachelor_Main_PCB.kicad_pcb]
2025-04-22 Changed SIM card connector to SF70S006VBAR2000
    the other one was not available
    [SF70S006VBAR2000.step, Wireless_modem.kicad_sch]
2025-04-22 add some 3D models
    [5302491_asm.stp, Bachelor_Main_PCB.kicad_pcb]
2025-04-22 changed symbol libraries to kiprjmod from 3dmodel
    [Bachelor_Main_PCB.kicad_pcb]
2025-04-22 changed footprint library the same way and added 3D-models to all components
    [Bachelor_Main_PCB.kicad_pcb]
2025-04-22 layouot decoupling caps to MCU
    [Bachelor_Main_PCB.kicad_pcb]
2025-04-22 Rearanged components on layout
    [Bachelor_Main_PCB.kicad_pcb, Microcontroller.kicad_sch, Power_supply.kicad_sch]
2025-04-22 Rotated BAT
    [Bachelor_Main_PCB.kicad_pcb]
2025-04-23 arrange modem components
    [Bachelor_Main_PCB.kicad_pcb]
2025-04-23 More arrange modem comp
    [Bachelor_Main_PCB.kicad_pcb]
2025-04-23 arrange SIM card components. Fix DSW1 and DSW2 circuit.
    [Bachelor_Main_PCB.kicad_sch, Microcontroller.kicad_sch, Power_supply.kicad_sch, Wireless_modem.kicad_sch]
2025-04-23 arrange Modem mosfets
    [Bachelor_Main_PCB.kicad_pcb, Wireless_modem.kicad_sch]
2025-04-23 Add custom nettie for Waveguide. Aligned modem connectors
    [Bachelor_Main_PCB.kicad_pcb, Wireless_modem.kicad_sch]
2025-04-23 Change footprint of RPICM to better courtyard
    so as to not cause errors with components underneath
2025-04-23 place modem testpoints
    [Bachelor_Main_PCB.kicad_pcb]
2025-04-23 add gnd plane and fixed MCU bypass cap trace error
    [Bachelor_Main_PCB.kicad_pcb]
2025-04-23 Updated gnd planes
    [Bachelor_Main_PCB.kicad_pcb]
2025-04-23 MODEM testppoints and gnd fill
    [Bachelor_Main_PCB.kicad_pcb]
2025-04-24 Sim card testpoints
    [Bachelor_Main_PCB.kicad_pcb]
2025-04-24 complete Modem testpoints
    [Bachelor_Main_PCB.kicad_pcb]
2025-04-24 Route SIMcard and 3v5 modem
    [Bachelor_Main_PCB.kicad_pcb, Wireless_modem.kicad_sch]
2025-04-24 SD card pwr. legends for leds
    [Bachelor_Main_PCB.kicad_pcb]
2025-04-24 Rearanged MCU
    [Bachelor_Main_PCB.kicad_pcb]
2025-04-24 USB3320 arrange CAPS
    [Bachelor_Main_PCB.kicad_pcb]
2025-04-24 Fixed polygons are now filled zones
    [Bachelor_Main_PCB.kicad_pcb]
2025-04-24 continue PSU layout
    [Bachelor_Main_PCB.kicad_pcb]
2025-04-24 Completed PSU layout
    [Bachelor_Main_PCB.kicad_pcb]
2025-04-24 Fixing PSU layout
    [Bachelor_Main_PCB.kicad_pcb]
2025-04-24 Duplicate PSU layout
    [Bachelor_Main_PCB.kicad_pcb]
2025-04-24 Fixed Batery paste layer and shrunk PCB
    [Bachelor_Main_PCB.kicad_pcb]
2025-04-24 Layout ideal diode
    [Bachelor_Main_PCB.kicad_pcb]
2025-04-24 Changed V_IN on adc mcu sense pin to V_VIN_MEAS
    [Bachelor_Main_PCB.kicad_sch, Microcontroller.kicad_sch, Power_supply.kicad_sch, Raspbery_Pi_CM_4.kicad_sch]
2025-04-24 change IDEAL DIODE
    [Bachelor_Main_PCB.kicad_pcb]
2025-04-25 Text from meeting with julia
    [Microcontroller.kicad_sch, Power_supply.kicad_sch]
2025-04-25 Fix VIN_MEAS voltage divider
    [Power_supply.kicad_sch]
2025-04-25 resized R7 and R6 from 10k each
    [Microcontroller.kicad_sch, Power_supply.kicad_sch]
2025-04-25 Same as last
    [Microcontroller.kicad_sch]
2025-04-25 smal fixes
    [Bachelor_Main_PCB.kicad_pcb]
2025-04-25 Update SMPS for MCU
    [Bachelor_Main_PCB.kicad_pcb]
2025-04-25 Fix RPI 3d model.
    [Bachelor_Main_PCB.kicad_pcb, Bachelor_Main_PCB.kicad_sch, Microcontroller.kicad_sch]
2025-04-25 add SMPS plane under MCU
    [Bachelor_Main_PCB.kicad_pcb]
2025-04-25 route VCAP bypass
    [Bachelor_Main_PCB.kicad_pcb]
2025-04-25 further bypass caping
    [Bachelor_Main_PCB.kicad_pcb]
2025-04-25 no cap further cap
    [Bachelor_Main_PCB.kicad_pcb]
2025-04-25 No way it is more!!!
    [Bachelor_Main_PCB.kicad_pcb]
2025-04-25 Add LED to USB_HUB
    [Microcontroller.kicad_sch, USB_HUB.kicad_sch]
2025-04-25 Routed USBhub/transiever
    [Bachelor_Main_PCB.kicad_pcb]
2025-04-25 Modem fixing
    [Bachelor_Main_PCB.kicad_pcb]
2025-04-25 Route SIM data
    [Bachelor_Main_PCB.kicad_pcb]
2025-04-25 Ready for Diff pair
    [Bachelor_Main_PCB.kicad_pcb]
2025-04-25 Route MODEM DIFF
    [Bachelor_Main_PCB.kicad_pcb]
2025-04-25 Route DIFF
    [Bachelor_Main_PCB.kicad_pcb]
2025-04-26 Route last USB
    [Bachelor_Main_PCB.kicad_pcb]
2025-04-26 Fully route USB hub
    [Bachelor_Main_PCB.kicad_pcb]
2025-04-26 Route al ULPI
    [Bachelor_Main_PCB.kicad_pcb]
2025-04-26 Route SD card
    [Bachelor_Main_PCB.kicad_pcb]
2025-04-26 RPI power
    [Bachelor_Main_PCB.kicad_pcb]
2025-04-26 RPI power after crash
    [Bachelor_Main_PCB.kicad_pcb]
2025-04-26 Align LEDS
    [Bachelor_Main_PCB.kicad_pcb]
2025-04-26 Align leds MORE
    [Bachelor_Main_PCB.kicad_pcb]
2025-04-26 adding power planes
    [Bachelor_Main_PCB.kicad_pcb]
2025-04-26 arrange PSU
    [Bachelor_Main_PCB.kicad_pcb]
2025-04-26 arange PSU
    [Bachelor_Main_PCB.kicad_pcb]
2025-04-26 Route more PSU
    [Bachelor_Main_PCB.kicad_pcb]
2025-04-26 PSU 5v rail
    [Bachelor_Main_PCB.kicad_pcb]
2025-04-26 Route debug
    [Bachelor_Main_PCB.kicad_pcb]
2025-04-26 start Audiomoth SD routing
    [Bachelor_Main_PCB.kicad_pcb]
2025-04-26 Completed SD routing
    [Bachelor_Main_PCB.kicad_pcb]
2025-04-26 Complete SD routing
    [Bachelor_Main_PCB.kicad_pcb]
2025-04-27 fixup traces
    [Bachelor_Main_PCB.kicad_pcb]
2025-04-27 Start routing RPI
    [Bachelor_Main_PCB.kicad_pcb]
2025-04-27 Done modem routing
    [Bachelor_Main_PCB.kicad_pcb]
2025-04-27 Route UART
    [Bachelor_Main_PCB.kicad_pcb]
2025-04-27 Done route RPI
    [Bachelor_Main_PCB.kicad_pcb]
2025-04-27 Fixing up clock signal
    [Bachelor_Main_PCB.kicad_pcb]
2025-04-27 More routing
    [Bachelor_Main_PCB.kicad_pcb]
2025-04-27 Anoying routing
    [Bachelor_Main_PCB.kicad_pcb]
2025-04-27 The routing never stops
    [Bachelor_Main_PCB.kicad_pcb]
2025-04-27 The routing continues to never stop
    [Bachelor_Main_PCB.kicad_pcb]
2025-04-27 You probably wont believe this but more routing
    [Bachelor_Main_PCB.kicad_pcb]
2025-04-27 THis may come as a shook but there has been EVEN more routing
    [Bachelor_Main_PCB.kicad_pcb]
2025-04-27 The fabric of reality is tearing, the routed traces are trying to hold it together
    [Bachelor_Main_PCB.kicad_pcb]
2025-04-27 The traces have ascended beyond our plane of existence
    [Bachelor_Main_PCB.kicad_pcb]
2025-04-27 The traces cry out in unison, the third impact is upon us
    [Bachelor_Main_PCB.kicad_pcb]
2025-04-27 Humanity endures countless eons of subjugation from the trace lord
    [Bachelor_Main_PCB.kicad_pcb]
2025-04-27 Until, a hero emerges. He fights against the empire inciting revolution
    [Bachelor_Main_PCB.kicad_pcb]
2025-04-27 In a final stand for the fate of the world the hero vanquishes the lord
    [Bachelor_Main_PCB.kicad_pcb]
2025-04-27 However the wounds sustained during the fight were to severe
    [Bachelor_Main_PCB.kicad_pcb]
2025-04-27 The hero is carried to the great willow tree where he grew up
    [Bachelor_Main_PCB.kicad_pcb]
2025-04-27 He rests underneath sunny skies, never shall we see his likeness again
    [Bachelor_Main_PCB.kicad_pcb]
2025-04-27 Add 2 100nF between MCU and Transceiver power planes for return path
    [Microcontroller.kicad_sch]
2025-04-27 Routing and ad silkprint
    [Bachelor_Main_PCB.kicad_pcb]
2025-04-27 RATSNEST IS DONE!!!
    [Bachelor_Main_PCB.kicad_pcb]
2025-04-27 adding GND vias
    [Bachelor_Main_PCB.kicad_pcb]
2025-04-27 GND VIAS
    [Bachelor_Main_PCB.kicad_pcb]
2025-04-27 Add GND to USB Chips
2025-04-27 GND vias and fix footprint vias
2025-04-28 GND vias and resized power zones
2025-04-28 Add mounting holes
    [Bachelor_Main_PCB.kicad_sch]
2025-04-28 Start DRC check
    [Bachelor_Main_PCB.kicad_sch]
2025-04-28 CHange RPICM solder mask expansion for pads
2025-04-28 Update mouting holes to m2.5 to use same screws as RPICM
    [Bachelor_Main_PCB.kicad_sch]
2025-04-28 Complete DRC
    [Bachelor_Main_PCB.kicad_sch, Raspbery_Pi_CM_4.kicad_sch]
2025-04-28 Add final fiducial and layer check section
    [Bachelor_Main_PCB.kicad_sch]
2025-04-28 Update vias on switch modes to not be bad
2025-04-28 Fixed switch mode CHIP GND
2025-04-28 Add MPN to all resistors. Only missing pinheaders
    [Microcontroller.kicad_sch, Power_supply.kicad_sch, Raspbery_Pi_CM_4.kicad_sch, USB_HUB.kicad_sch, Wireless_modem.kicad_sch]
2025-04-28 Changed Part-no which were incorrect
    [Microcontroller.kicad_sch, Raspbery_Pi_CM_4.kicad_sch, Wireless_modem.kicad_sch]
2025-04-29 removed duplicate 3d model for STM32
2025-04-30 Made 2 3d model step files for the PCB. one simple one complex
    [Bachelor_Main_PCB_simple.step]
2025-05-04 Removed part-no in schematics
    [Bachelor_Main_PCB.kicad_sch, Microcontroller.kicad_sch, Power_supply.kicad_sch, Raspbery_Pi_CM_4.kicad_sch, SD-Card_interface.kicad_sch, USB_HUB.kicad_sch, Wireless_modem.kicad_sch]
2025-05-18 Update page settings for all sheets. Add title, revision, date, etc.
    [Bachelor_Main_PCB.kicad_sch, Microcontroller.kicad_sch, Power_supply.kicad_sch, Raspbery_Pi_CM_4.kicad_sch, SD-Card_interface.kicad_sch, USB_HUB.kicad_sch, Wireless_modem.kicad_sch]
2025-05-18 Tidy up schematics
    [Microcontroller.kicad_sch, Power_supply.kicad_sch, Raspbery_Pi_CM_4.kicad_sch, Wireless_modem.kicad_sch]
2025-05-19 Made interactive HTML bom
2025-05-19 Update regulator PN to the PFM version, add notes for next revision.
    [Microcontroller.kicad_sch, Power_supply.kicad_sch, Raspbery_Pi_CM_4.kicad_sch]
2025-05-23 Changes to the capacitive multiplier Simulation files
    [Raspbery_Pi_CM_4.kicad_sch]
2025-05-27 Add fusion assembly
    [Bachelor_Main_pcb_Housing v15.f3d]
